hurobomaster/TriCoSphere/STL/TriCoSphere - 单指节-3 挡边轴承3-6-2.5-25.STL

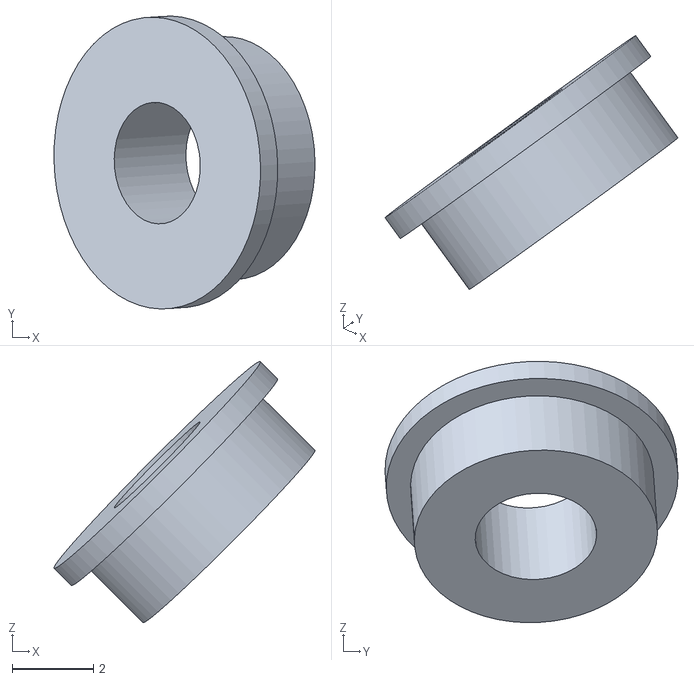
[picture p2: CAD file, 2026-02-28]
STL/TriCoSphere - 单指节-3 挡边轴承3-6-2.5-25.STL
6.43 x 7.22 x 6.44
