hurobomaster/TriCoSphere/STL/TriCoSphere - 单指节-2 M2.5锁紧螺母-1.STL

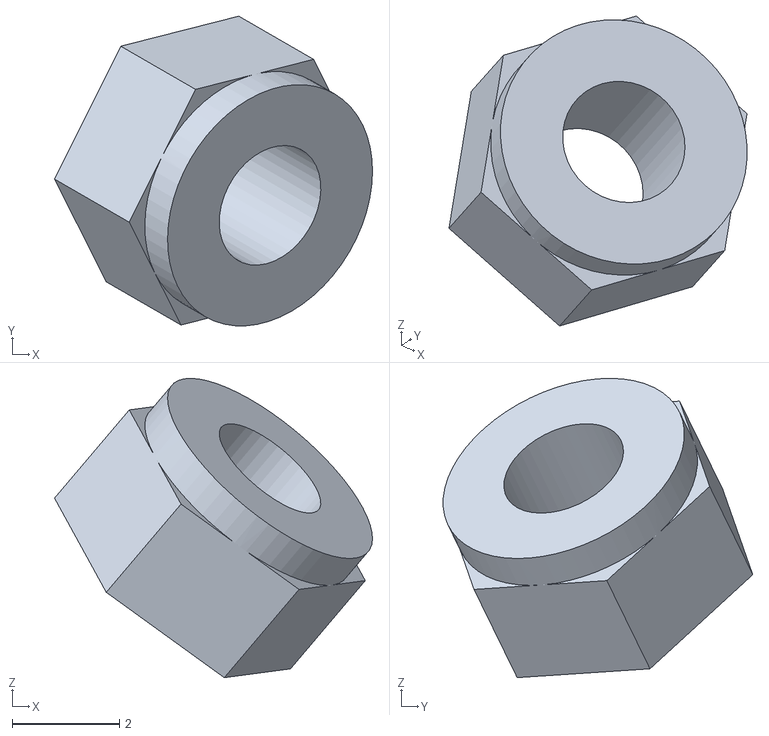
[picture p3: CAD file, 2026-02-28]
STL/TriCoSphere - 单指节-2 M2.5锁紧螺母-1.STL
5.93 x 5.77 x 5.58
