hurobomaster/TriCoSphere/STL/TriCoSphere - 单指节-3 3-1支架-1.STL

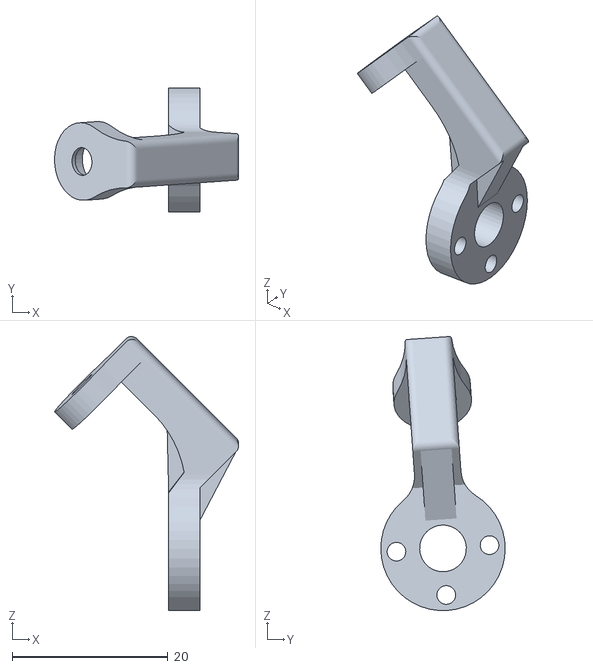
[picture p4: CAD file, 2026-02-28]
STL/TriCoSphere - 单指节-3 3-1支架-1.STL
23.7 x 16.0 x 35.2
