hurobomaster/TriCoSphere/STL/TriCoSphere - 单指节-3 4-1支架-2.STL

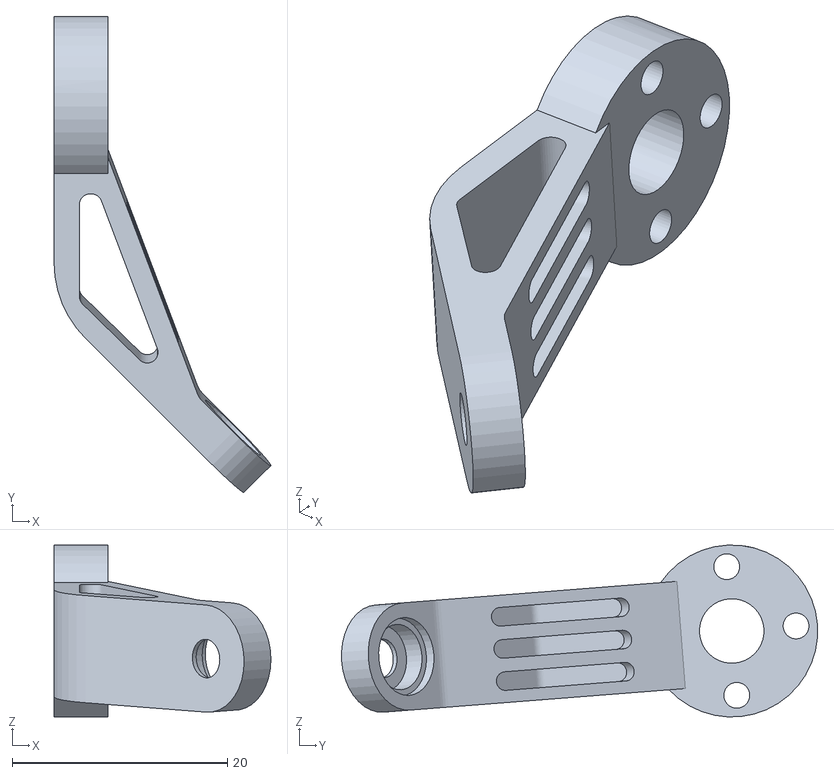
[picture p5: CAD file, 2026-02-28]
STL/TriCoSphere - 单指节-3 4-1支架-2.STL
20.2 x 44.3 x 16.0
