hurobomaster/TriCoSphere/STL/TriCoSphere - 单指节-2 挡边轴承3-6-2.5-26.STL

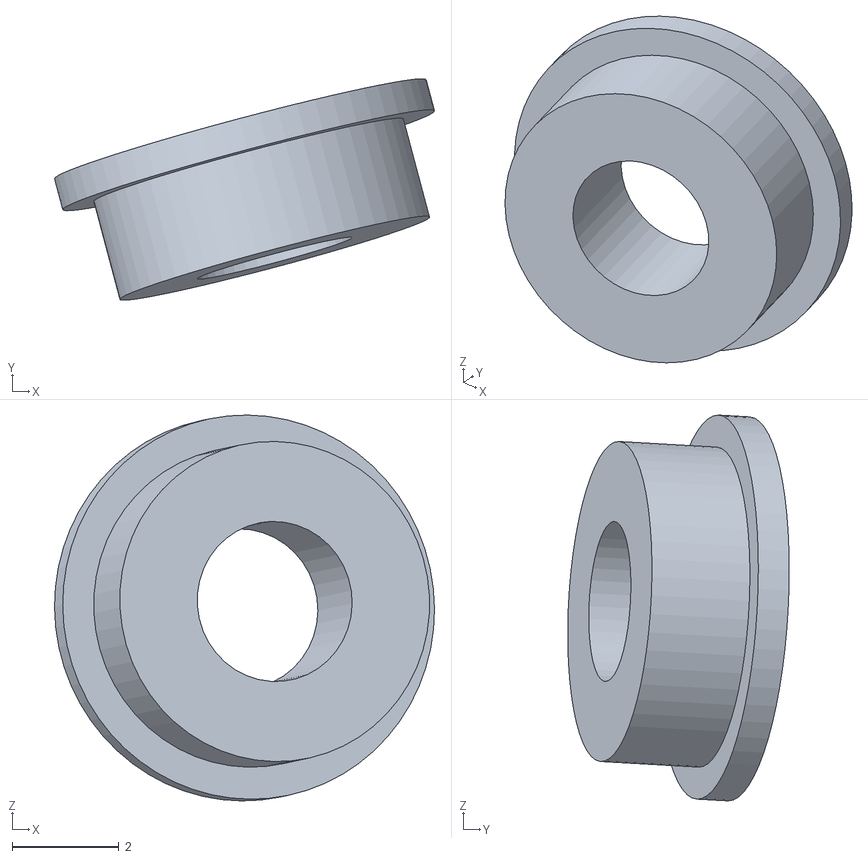
[picture p6: CAD file, 2026-02-28]
STL/TriCoSphere - 单指节-2 挡边轴承3-6-2.5-26.STL
7.11 x 4.15 x 7.22
