hurobomaster/TriCoSphere/STL/TriCoSphere - 单指节-2 长腿2-1.STL

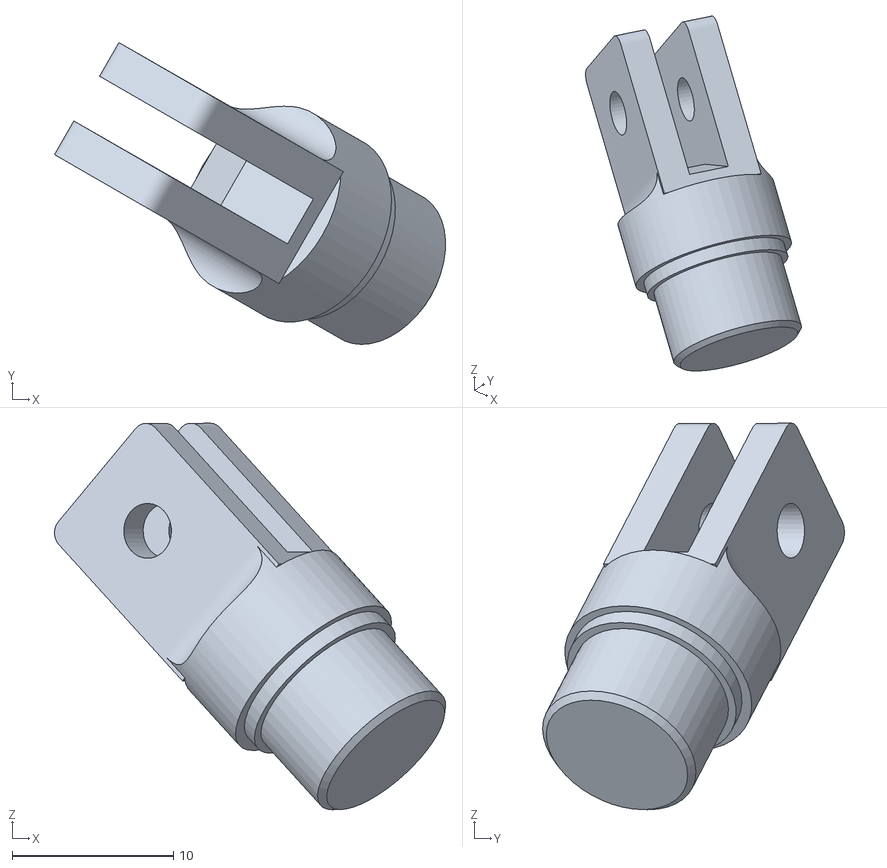
[picture p7: CAD file, 2026-02-28]
STL/TriCoSphere - 单指节-2 长腿2-1.STL
24.2 x 18.7 x 23.9
