hurobomaster/TriCoSphere/STL/TriCoSphere - 单指节-1 中指模块-1.STL

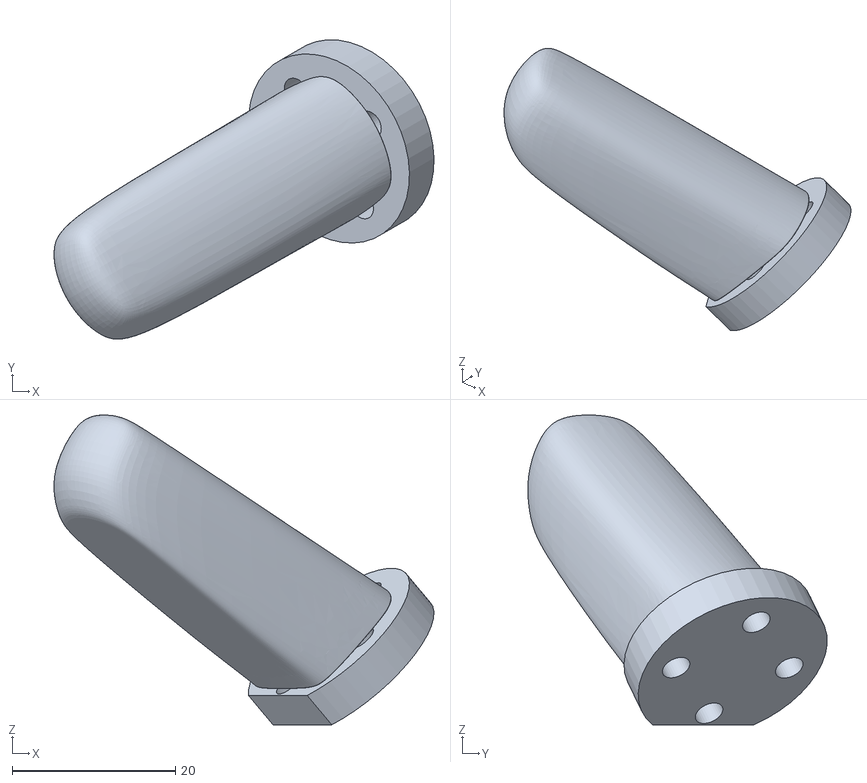
[picture p8: CAD file, 2026-02-28]
STL/TriCoSphere - 单指节-1 中指模块-1.STL
46.5 x 36.6 x 37.9
