hurobomaster/TriCoSphere/STL/TriCoSphere - 单指节-2 推力球轴承3_8_3.5-5.STL

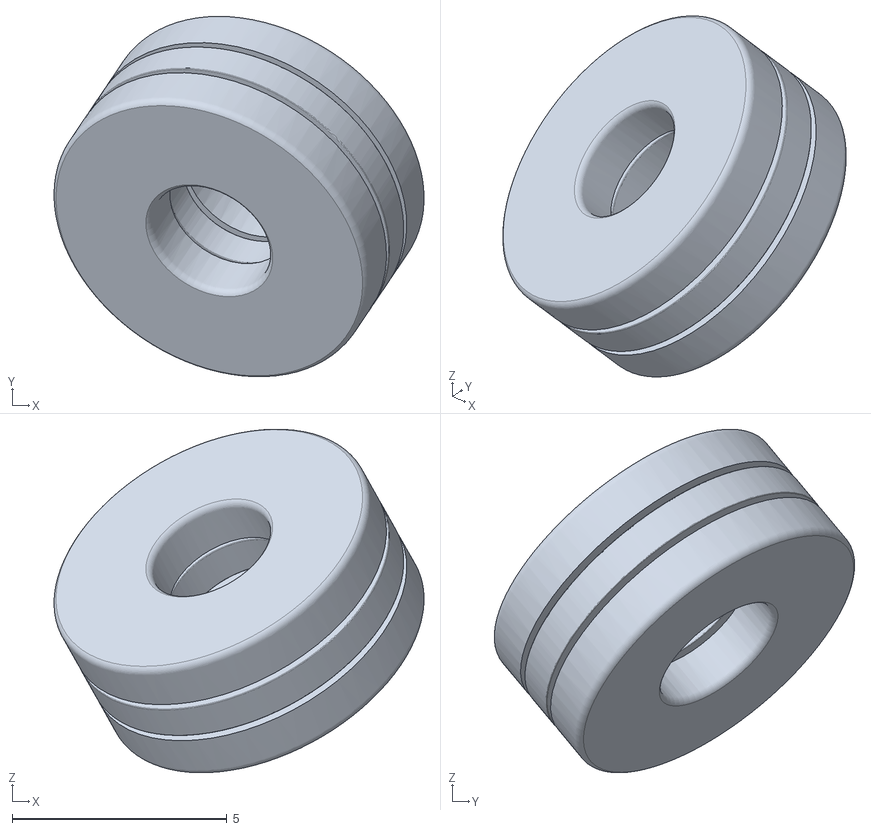
[picture p9: CAD file, 2026-02-28]
STL/TriCoSphere - 单指节-2 推力球轴承3_8_3.5-5.STL
8.62 x 8.39 x 8.00
