hurobomaster/TriCoSphere/STL/TriCoSphere - 单指节-1 M2.5塞打-2.STL

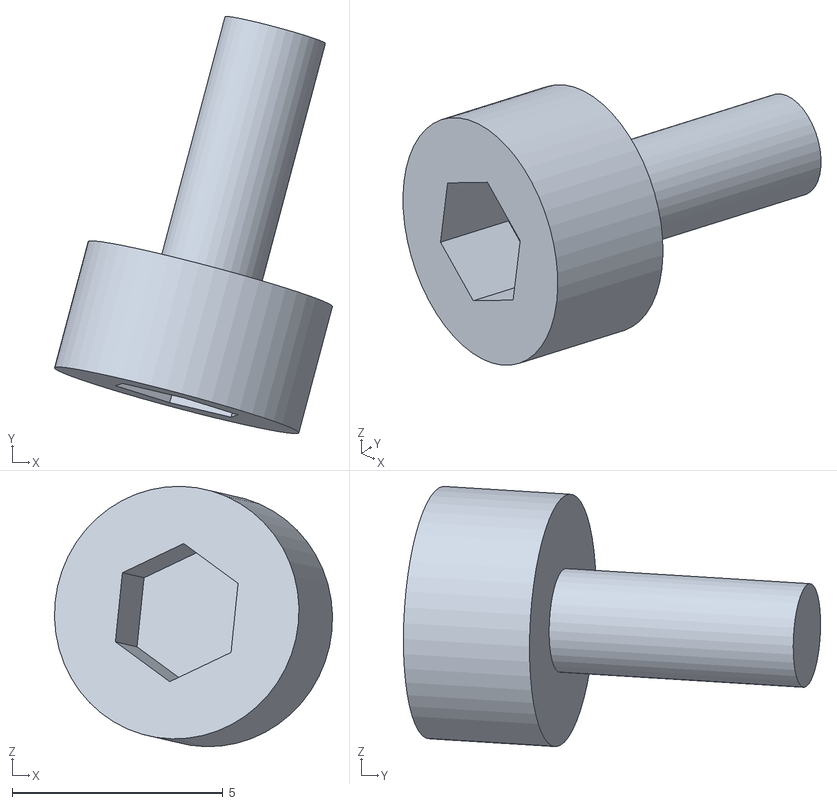
[picture p10: CAD file, 2026-02-28]
STL/TriCoSphere - 单指节-1 M2.5塞打-2.STL
6.59 x 9.89 x 6.17
