hurobomaster/TriCoSphere/STL/TriCoSphere - 单指节-3 1-2支架-1.STL

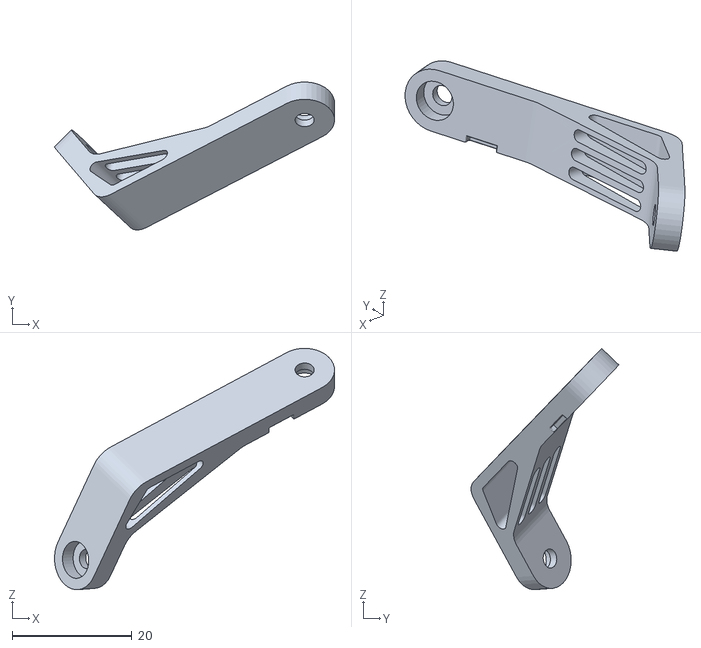
[picture p11: CAD file, 2026-02-28]
STL/TriCoSphere - 单指节-3 1-2支架-1.STL
46.8 x 24.7 x 40.3
