hurobomaster/TriCoSphere/STL/TriCoSphere - 单指节-3 长边件-9.STL

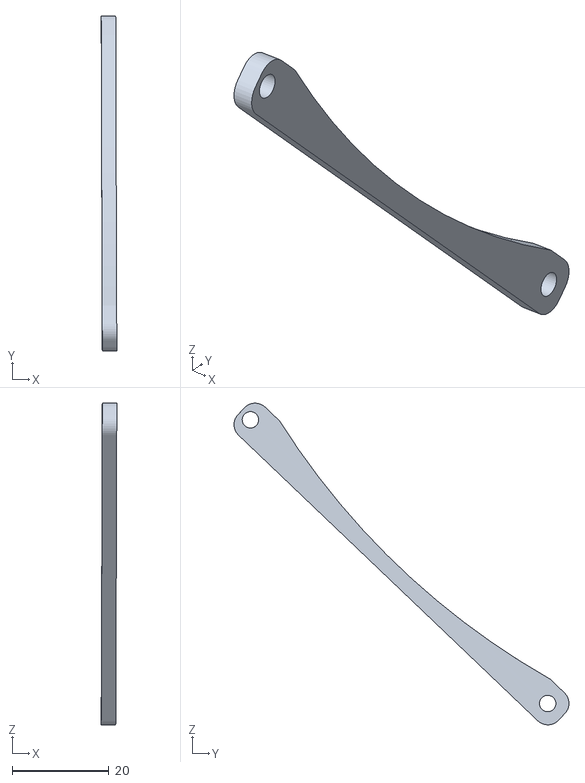
[picture p12: CAD file, 2026-02-28]
STL/TriCoSphere - 单指节-3 长边件-9.STL
3.22 x 69.3 x 66.5
