hurobomaster/TriCoSphere/STL/TriCoSphere - 单指节-3 aututorM288-2.STL

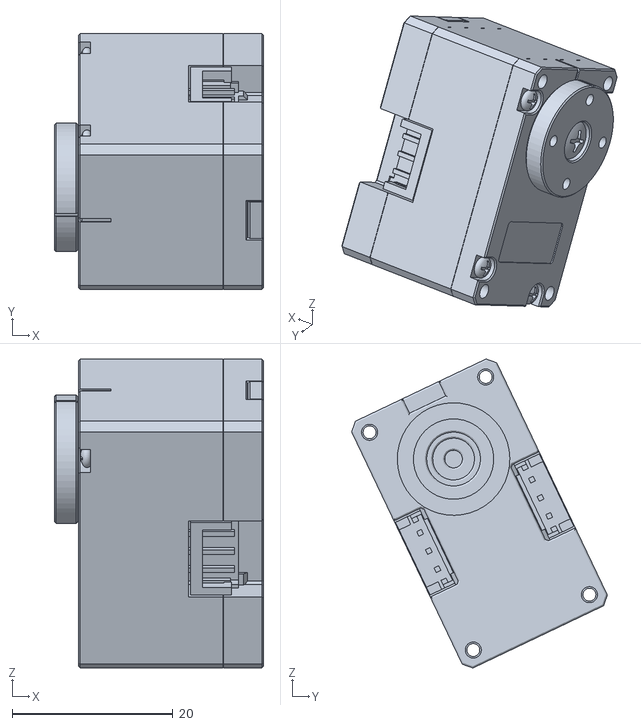
[picture p13: CAD file, 2026-02-28]
STL/TriCoSphere - 单指节-3 aututorM288-2.STL
26.0 x 31.8 x 38.4
