hurobomaster/TriCoSphere/STL/TriCoSphere - 单指节-2 内六角杯头螺栓 SCA SCAS[SCA-M3-L8]-2.STL

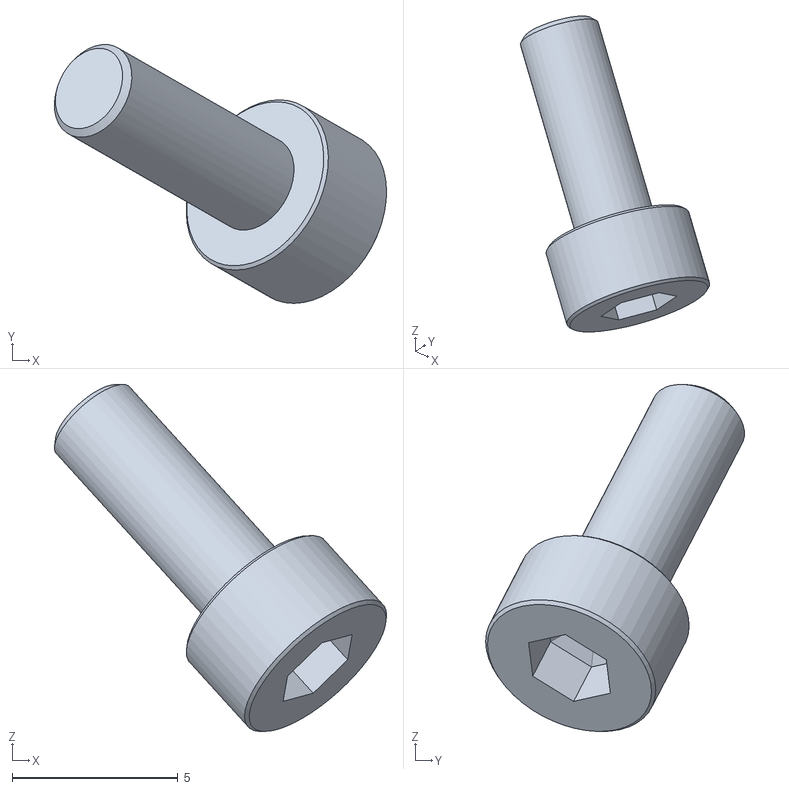
[picture p14: CAD file, 2026-02-28]
STL/TriCoSphere - 单指节-2 内六角杯头螺栓 SCA SCAS[SCA-M3-L8]-2.STL
10.0 x 7.80 x 10.5
