hurobomaster/TriCoSphere/STL/TriCoSphere - 单指节-1 aututorM288-1.STL

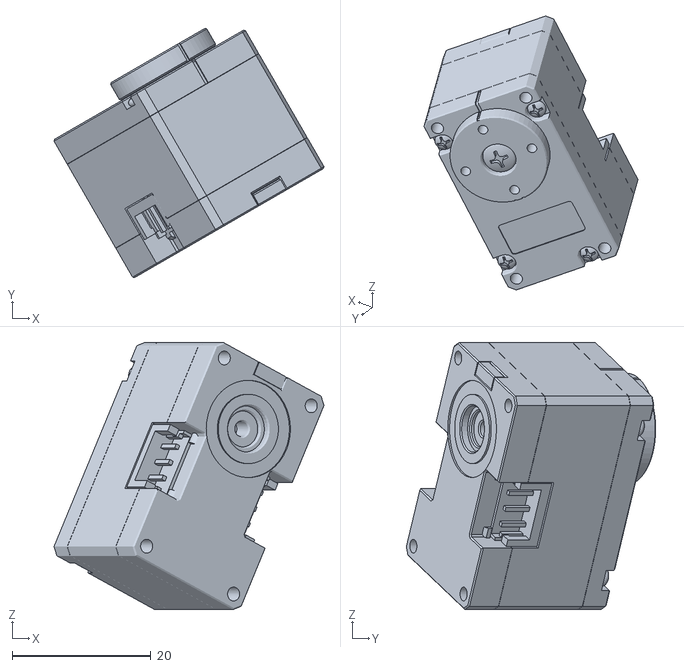
[picture p15: CAD file, 2026-02-28]
STL/TriCoSphere - 单指节-1 aututorM288-1.STL
38.9 x 35.9 x 38.4
