hurobomaster/TriCoSphere/STL/TriCoSphere - 单指节-2 1-2支架-1.STL

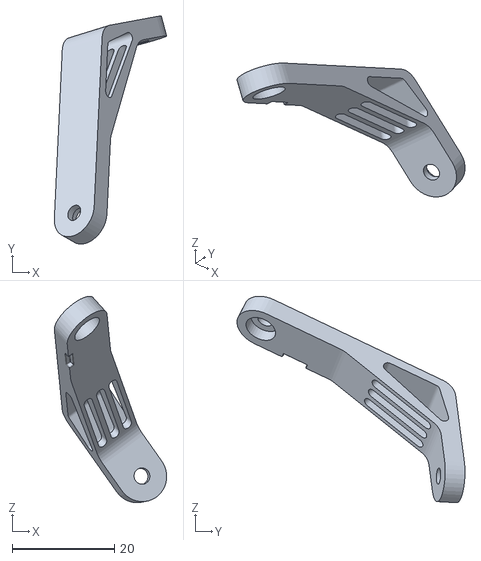
[picture p16: CAD file, 2026-02-28]
STL/TriCoSphere - 单指节-2 1-2支架-1.STL
21.9 x 44.5 x 40.3
