hurobomaster/TriCoSphere/STL/TriCoSphere - 单指节-3 内六角杯头螺栓 SCA SCAS[SCA-M3-L8]-4.STL

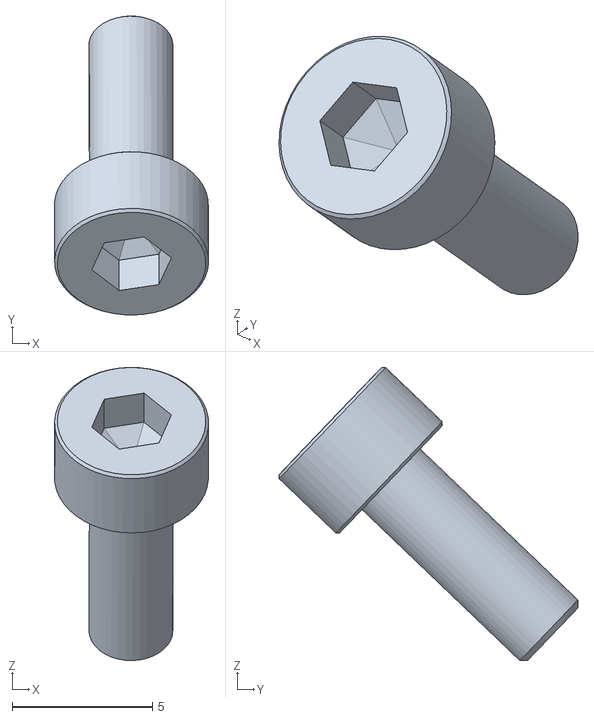
[picture p17: CAD file, 2026-02-28]
STL/TriCoSphere - 单指节-3 内六角杯头螺栓 SCA SCAS[SCA-M3-L8]-4.STL
5.50 x 10.7 x 10.5
