hurobomaster/TriCoSphere/STL/TriCoSphere - 单指节-3 2-2支架-4.STL

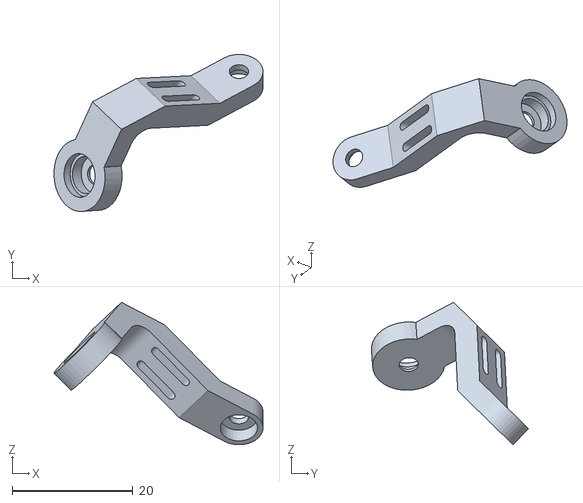
[picture p18: CAD file, 2026-02-28]
STL/TriCoSphere - 单指节-3 2-2支架-4.STL
34.7 x 26.1 x 23.6
