hurobomaster/TriCoSphere/STL/TriCoSphere - 单指节-2 挡边轴承3-6-2.5-16.STL

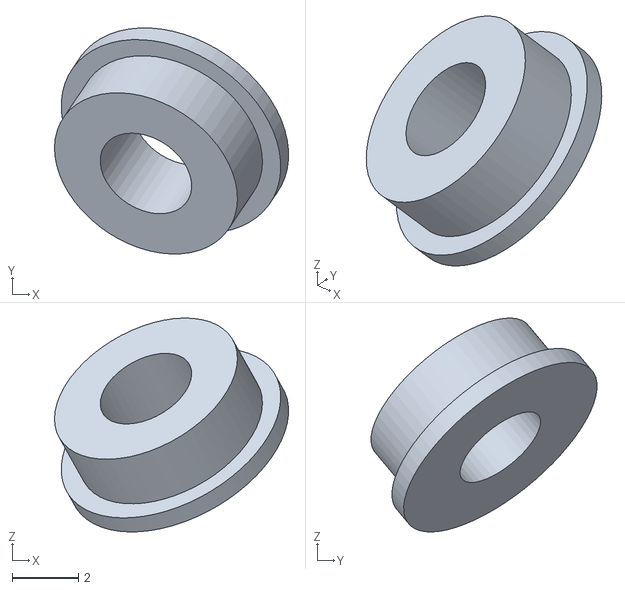
[picture p19: CAD file, 2026-02-28]
STL/TriCoSphere - 单指节-2 挡边轴承3-6-2.5-16.STL
7.05 x 6.80 x 6.44
