hurobomaster/TriCoSphere/STL/TriCoSphere - 单指节-2 挡边轴承3-6-2.5-25.STL

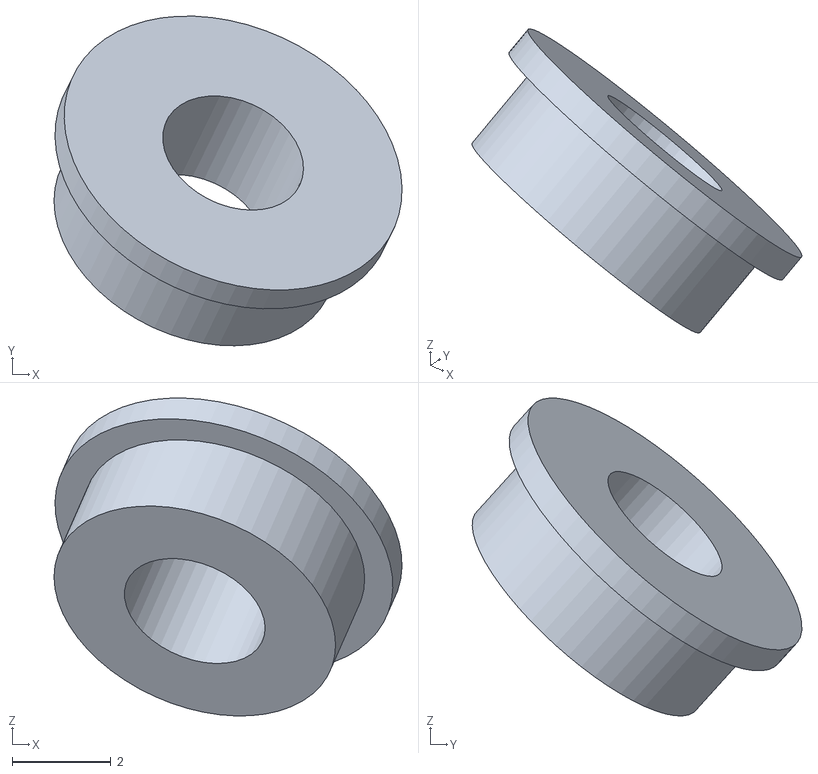
[picture p20: CAD file, 2026-02-28]
STL/TriCoSphere - 单指节-2 挡边轴承3-6-2.5-25.STL
7.05 x 6.68 x 6.44
