hurobomaster/TriCoSphere/STL/TriCoSphere - 单指节-3 短边连接-1.STL

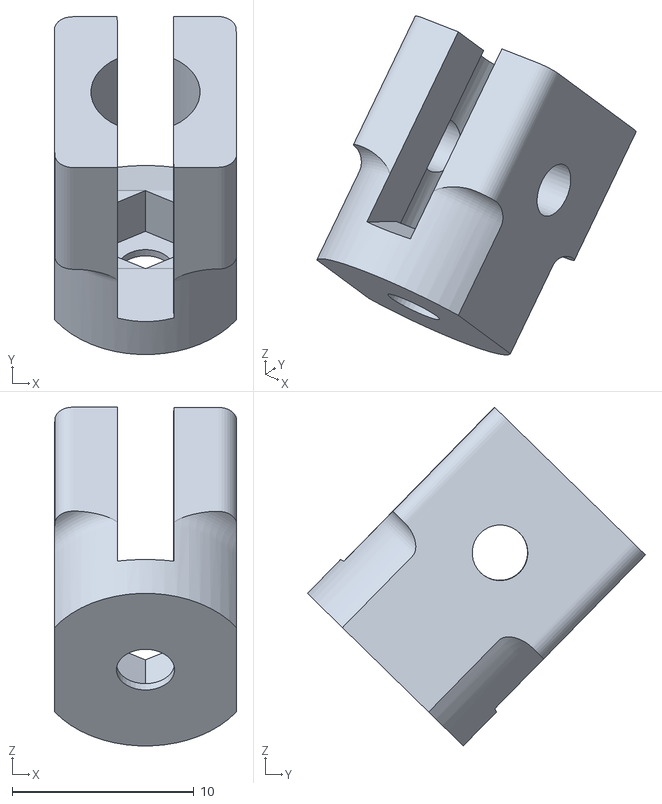
[picture p21: CAD file, 2026-02-28]
STL/TriCoSphere - 单指节-3 短边连接-1.STL
10.0 x 18.6 x 18.6
