hurobomaster/TriCoSphere/STL/TriCoSphere - 单指节-1 推力球轴承3_8_3.5-6.STL

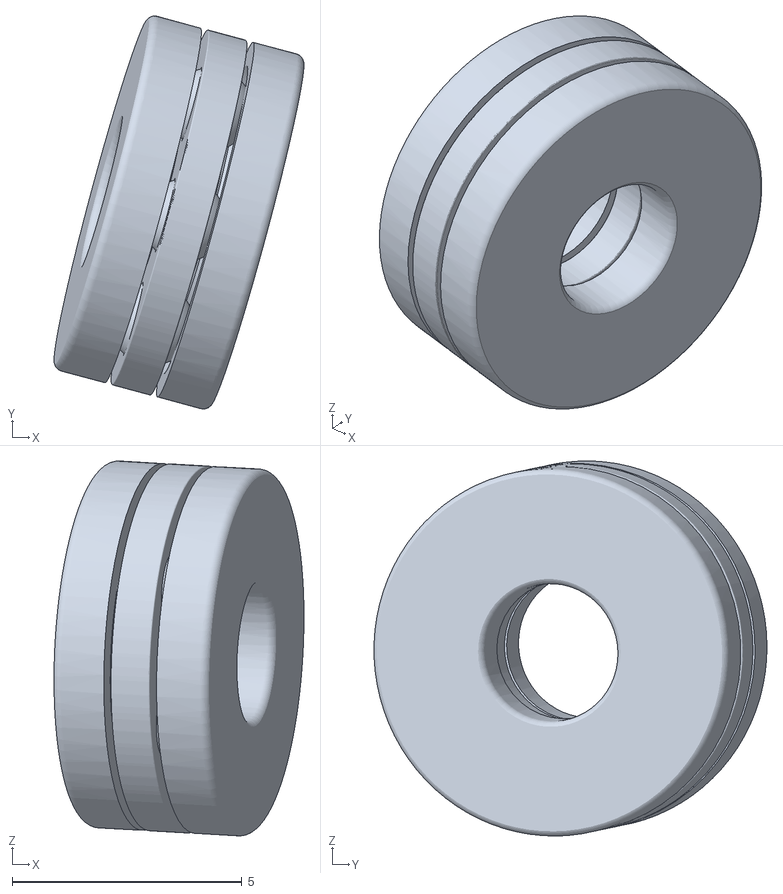
[picture p22: CAD file, 2026-02-28]
STL/TriCoSphere - 单指节-1 推力球轴承3_8_3.5-6.STL
5.44 x 8.55 x 8.16
