hurobomaster/TriCoSphere/STL/TriCoSphere - 单指节-1 4-1支架-1.STL

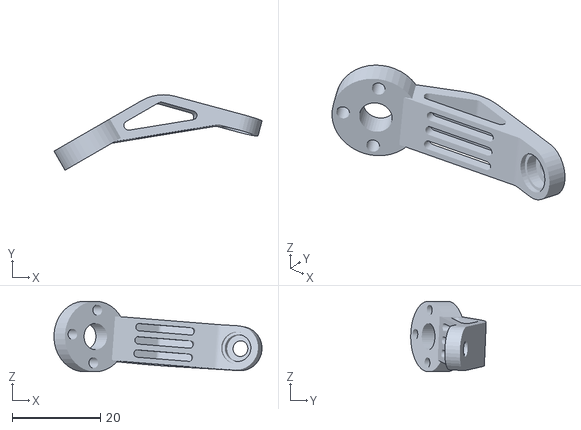
[picture p23: CAD file, 2026-02-28]
STL/TriCoSphere - 单指节-1 4-1支架-1.STL
47.2 x 17.1 x 16.0
