hurobomaster/TriCoSphere/STL/TriCoSphere - 单指节-3 推力球轴承3_8_3.5-9.STL

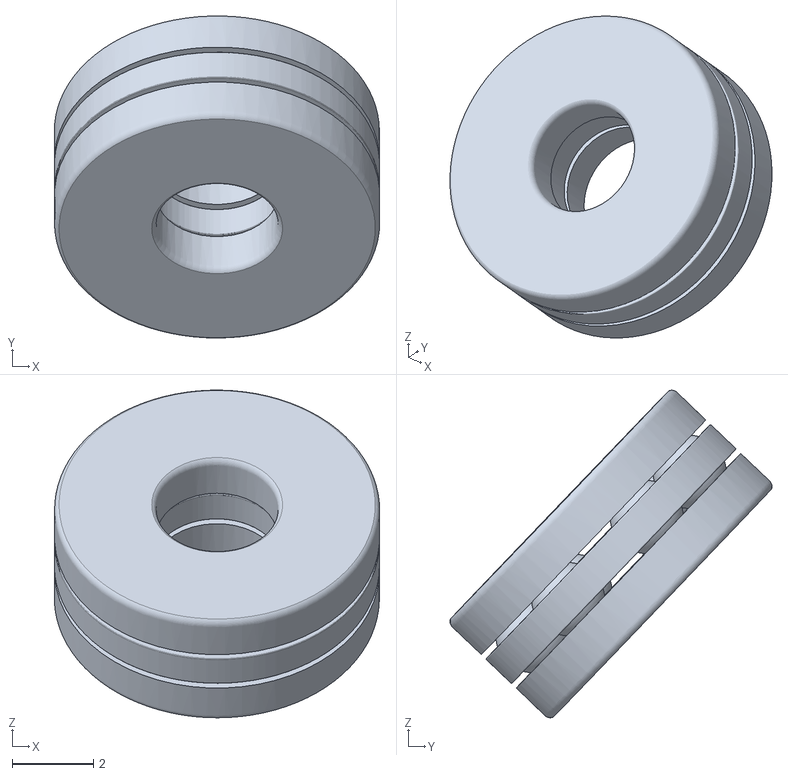
[picture p24: CAD file, 2026-02-28]
STL/TriCoSphere - 单指节-3 推力球轴承3_8_3.5-9.STL
8.01 x 7.92 x 8.06
