hurobomaster/TriCoSphere/STL/TriCoSphere - 单指节-3 推力球轴承3_8_3.5-7.STL

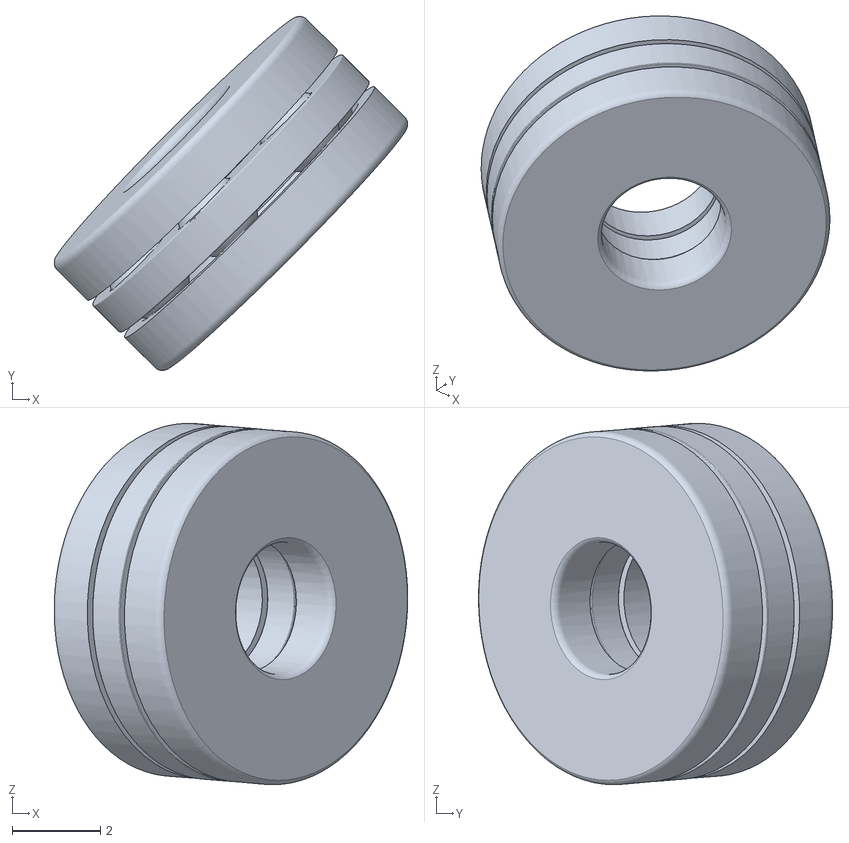
[picture p25: CAD file, 2026-02-28]
STL/TriCoSphere - 单指节-3 推力球轴承3_8_3.5-7.STL
7.99 x 8.01 x 8.17
