hurobomaster/TriCoSphere/STL/TriCoSphere - 单指节-1 M3螺母-4.STL

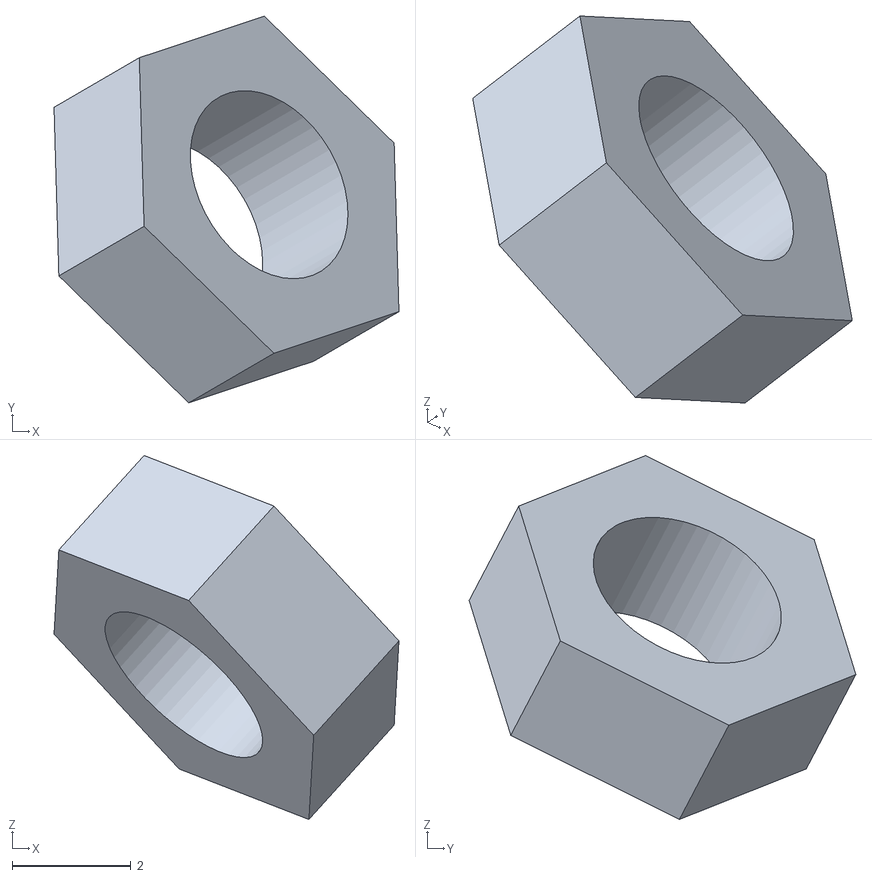
[picture p26: CAD file, 2026-02-28]
STL/TriCoSphere - 单指节-1 M3螺母-4.STL
5.81 x 6.51 x 6.13
