hurobomaster/TriCoSphere/STL/TriCoSphere - 单指节-2 超薄轴承-3.STL

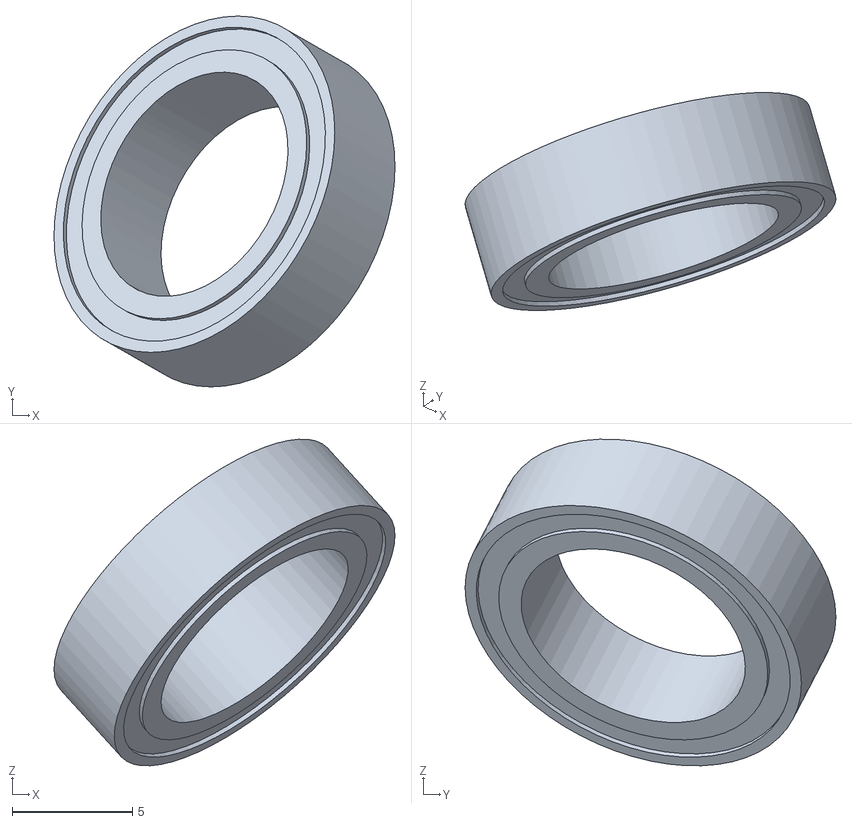
[picture p27: CAD file, 2026-02-28]
STL/TriCoSphere - 单指节-2 超薄轴承-3.STL
14.2 x 15.4 x 13.6
