hurobomaster/TriCoSphere/STL/TriCoSphere - 单指节-3 长腿盖-1.STL

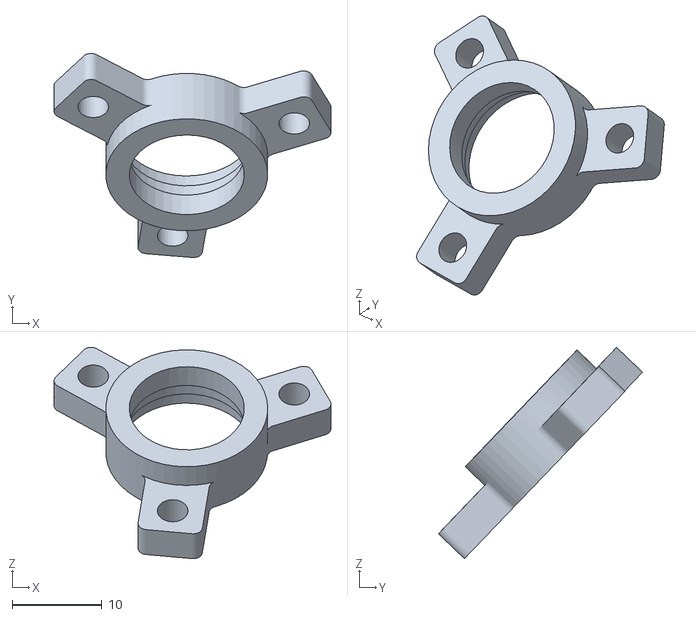
[picture p28: CAD file, 2026-02-28]
STL/TriCoSphere - 单指节-3 长腿盖-1.STL
30.8 x 22.7 x 23.5
