hurobomaster/TriCoSphere/STL/TriCoSphere - 单指节-1 推力球轴承3_8_3.5-7.STL

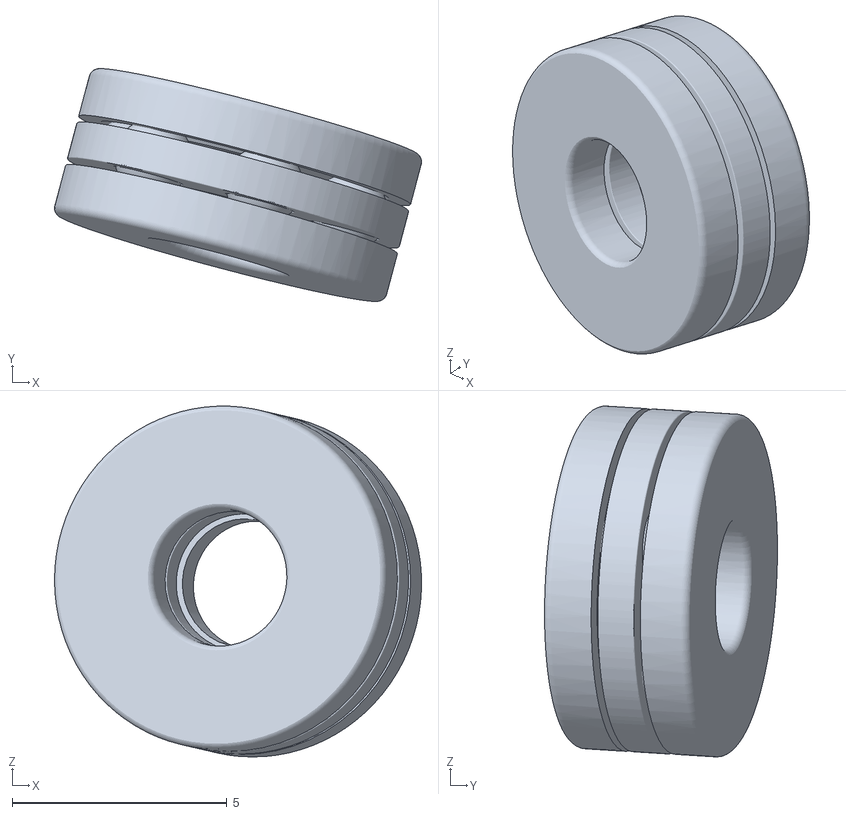
[picture p29: CAD file, 2026-02-28]
STL/TriCoSphere - 单指节-1 推力球轴承3_8_3.5-7.STL
8.55 x 5.43 x 8.17
