hurobomaster/TriCoSphere/STL/TriCoSphere - 单指节-1 2-1支架-1.STL

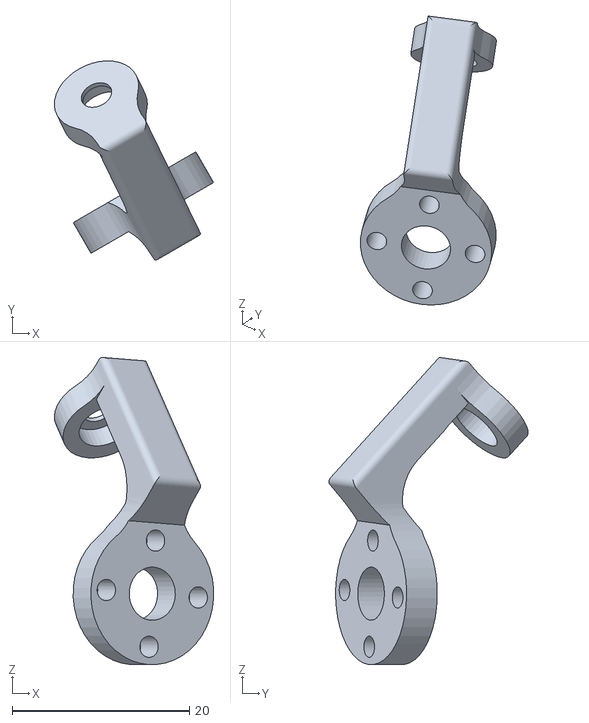
[picture p30: CAD file, 2026-02-28]
STL/TriCoSphere - 单指节-1 2-1支架-1.STL
18.0 x 22.5 x 34.6
