hurobomaster/TriCoSphere/STL/TriCoSphere - 单指节-1 挡边轴承3-6-2.5-26.STL

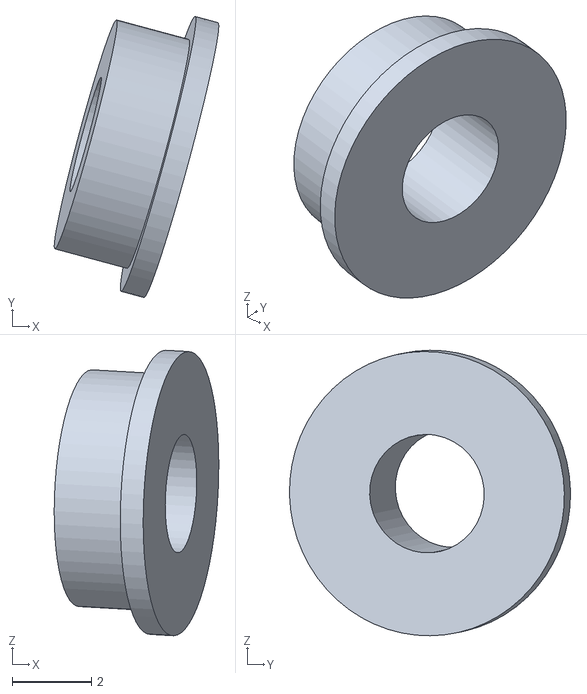
[picture p31: CAD file, 2026-02-28]
STL/TriCoSphere - 单指节-1 挡边轴承3-6-2.5-26.STL
4.16 x 7.11 x 7.22
