hurobomaster/TriCoSphere/STL/TriCoSphere - 单指节-1 4-1支架-2.STL

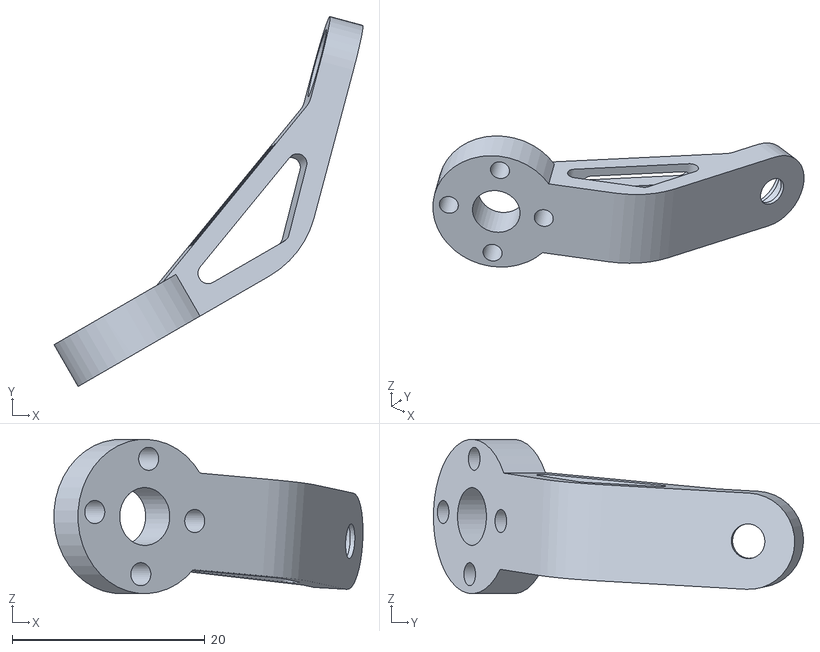
[picture p32: CAD file, 2026-02-28]
STL/TriCoSphere - 单指节-1 4-1支架-2.STL
32.0 x 38.4 x 16.0
