hurobomaster/TriCoSphere/STL/TriCoSphere - 单指节-2 2-1支架-1.STL

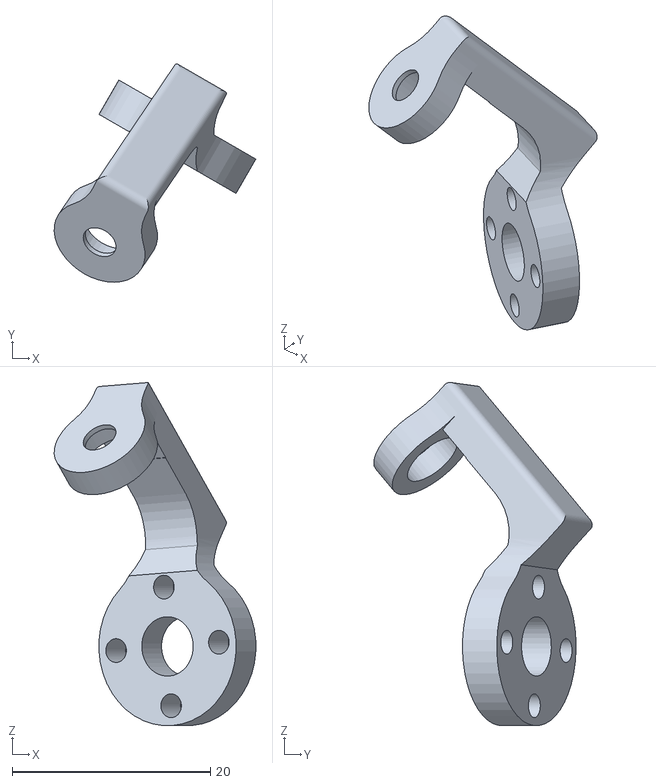
[picture p33: CAD file, 2026-02-28]
STL/TriCoSphere - 单指节-2 2-1支架-1.STL
20.4 x 22.1 x 34.6
