hurobomaster/TriCoSphere/STL/TriCoSphere - 单指节-2 2-2支架-4.STL

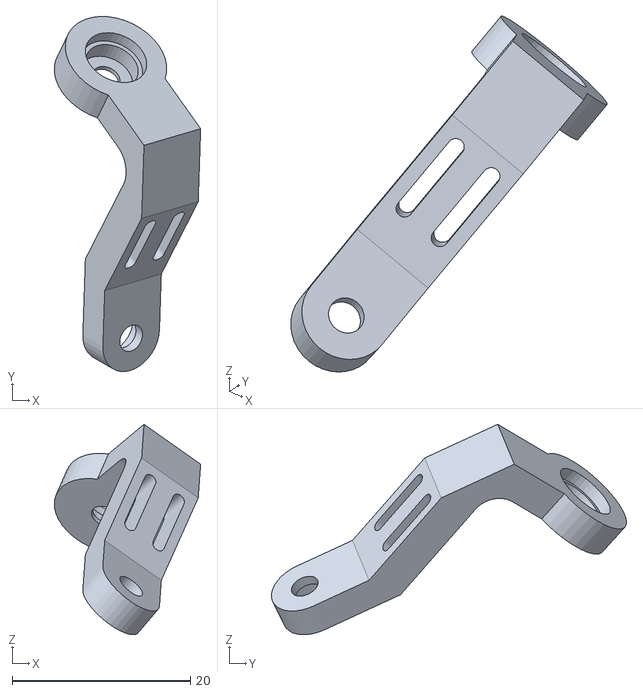
[picture p34: CAD file, 2026-02-28]
STL/TriCoSphere - 单指节-2 2-2支架-4.STL
16.4 x 39.9 x 23.6
