hurobomaster/TriCoSphere/STL/TriCoSphere - 单指节-2 M3螺母-4.STL

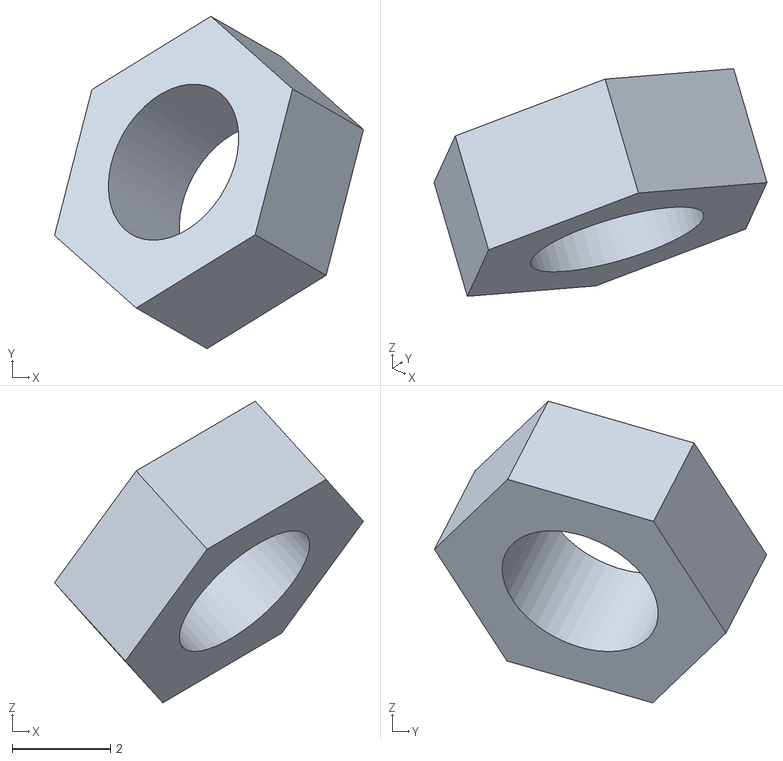
[picture p35: CAD file, 2026-02-28]
STL/TriCoSphere - 单指节-2 M3螺母-4.STL
6.28 x 6.75 x 6.13
