hurobomaster/TriCoSphere/STL/TriCoSphere - 单指节-1 M3螺母-1.STL

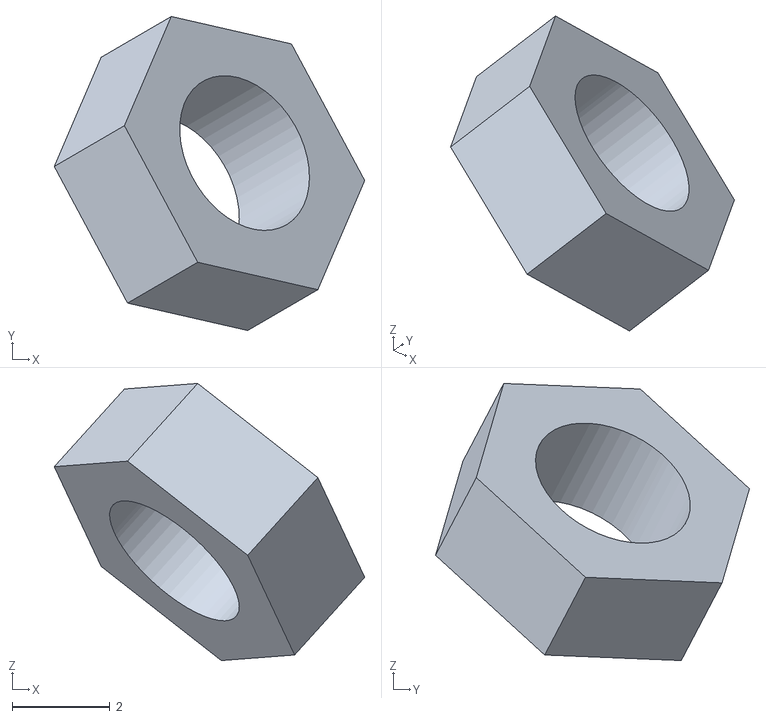
[picture p36: CAD file, 2026-02-28]
STL/TriCoSphere - 单指节-1 M3螺母-1.STL
6.36 x 6.43 x 5.67
