hurobomaster/TriCoSphere/STL/TriCoSphere - 单指节-2 挡边轴承3-6-2.5-21.STL

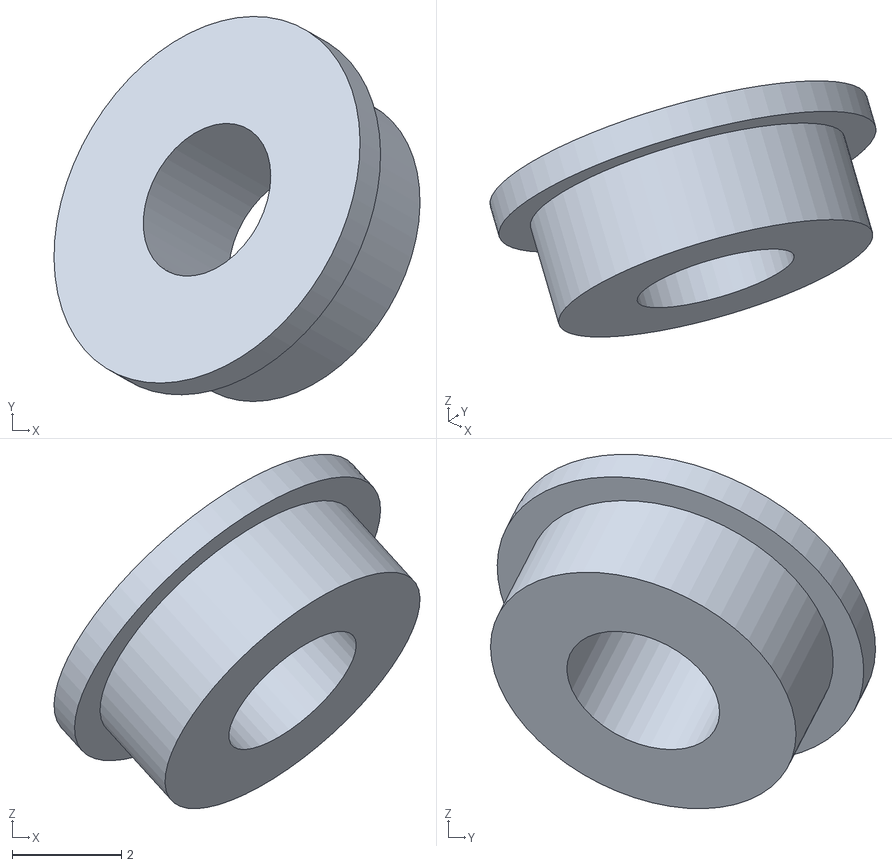
[picture p37: CAD file, 2026-02-28]
STL/TriCoSphere - 单指节-2 挡边轴承3-6-2.5-21.STL
6.71 x 7.06 x 6.49
