hurobomaster/TriCoSphere/STL/TriCoSphere - 单指节-3 长腿2-1.STL

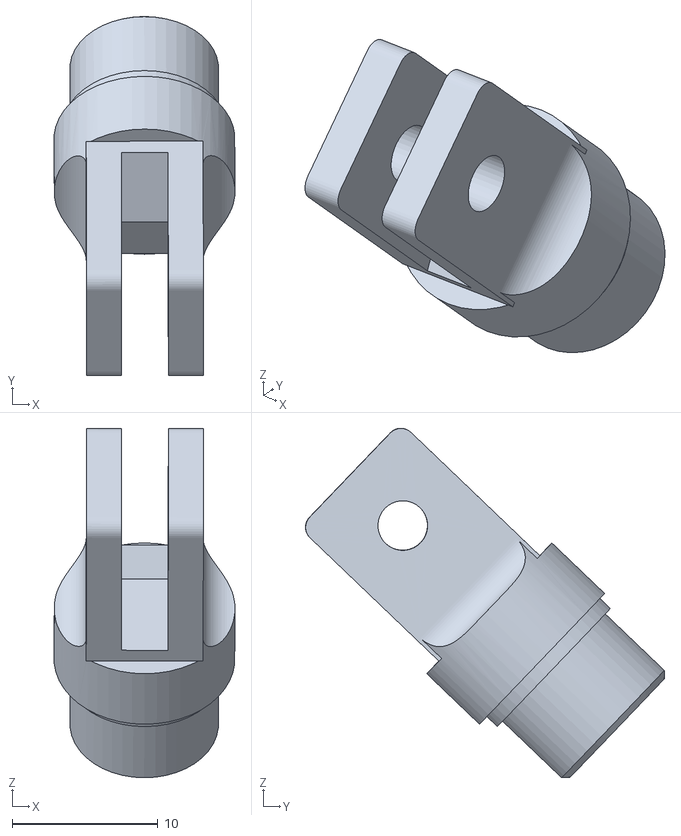
[picture p38: CAD file, 2026-02-28]
STL/TriCoSphere - 单指节-3 长腿2-1.STL
12.4 x 24.6 x 23.9
