hurobomaster/TriCoSphere/STL/TriCoSphere - 单指节-3 M2.5塞打-4.STL

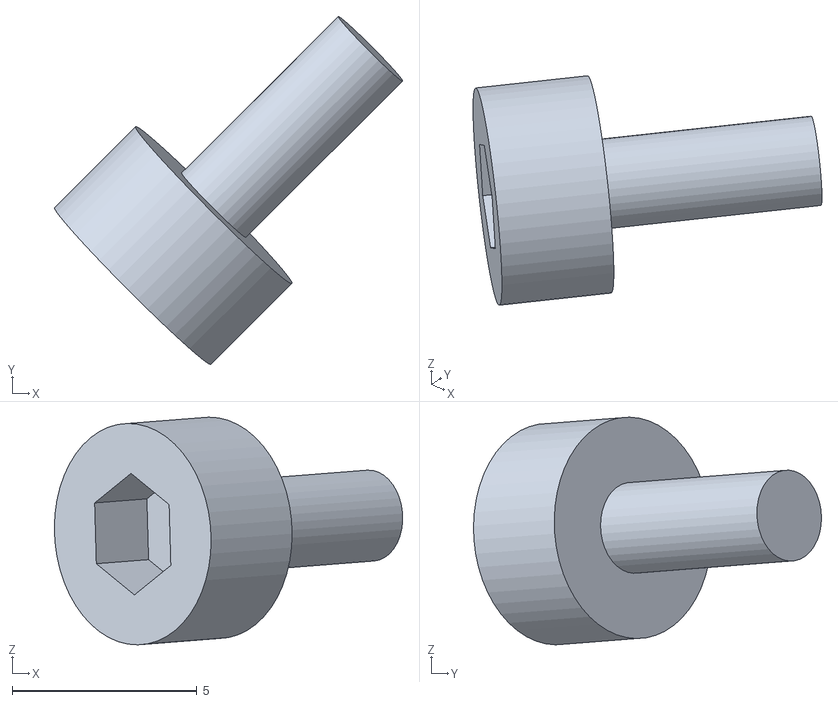
[picture p39: CAD file, 2026-02-28]
STL/TriCoSphere - 单指节-3 M2.5塞打-4.STL
9.43 x 9.42 x 6.16
