hurobomaster/TriCoSphere/STL/TriCoSphere - 单指节-3 挡边轴承3-6-2.5-9.STL

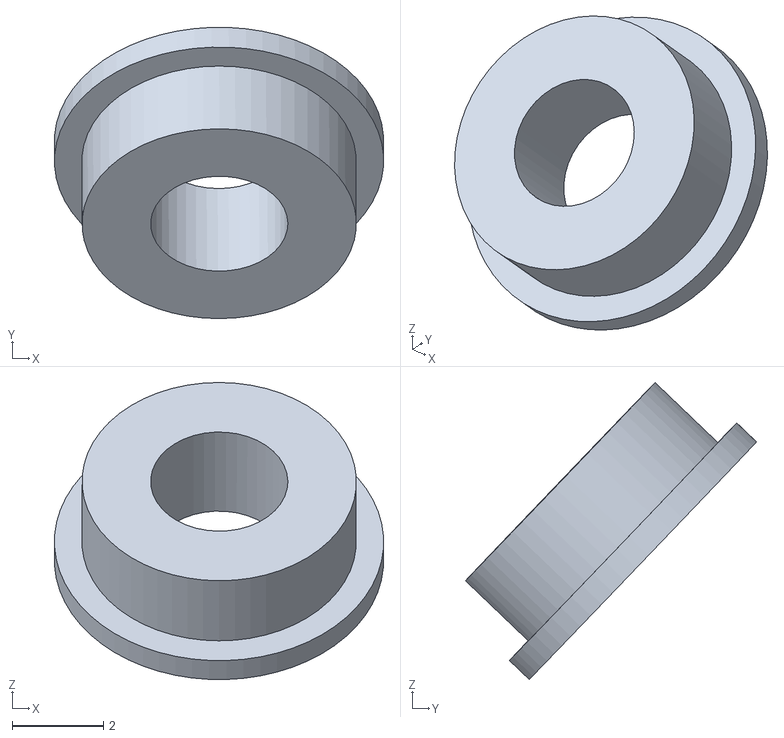
[picture p40: CAD file, 2026-02-28]
STL/TriCoSphere - 单指节-3 挡边轴承3-6-2.5-9.STL
7.19 x 6.37 x 6.49
