hurobomaster/TriCoSphere/STL/TriCoSphere - 单指节-1 M2.5塞打-5.STL

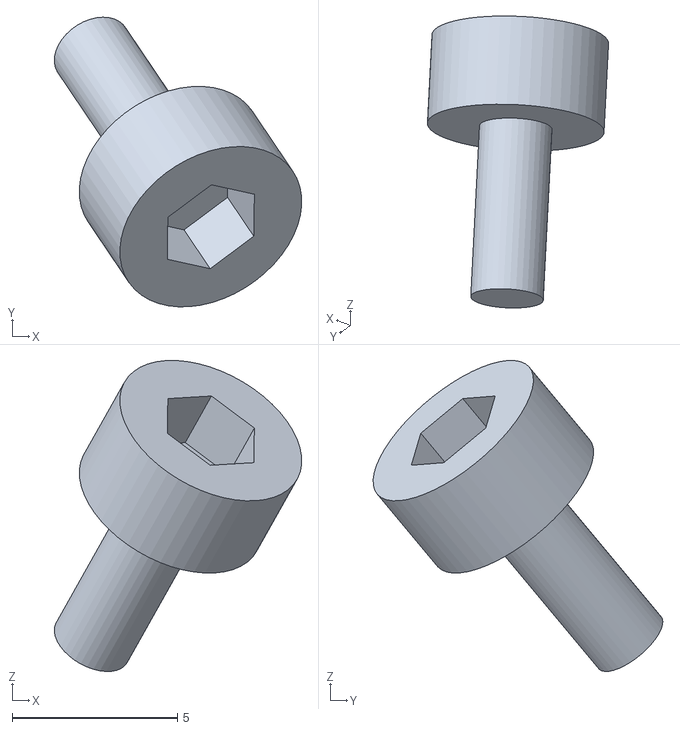
[picture p41: CAD file, 2026-02-28]
STL/TriCoSphere - 单指节-1 M2.5塞打-5.STL
7.49 x 8.77 x 9.42
