hurobomaster/TriCoSphere/STL/TriCoSphere - 单指节-1 长腿1-2.STL

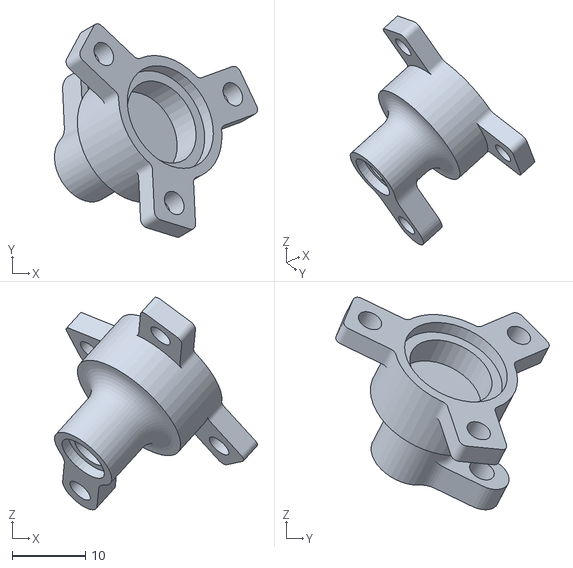
[picture p42: CAD file, 2026-02-28]
STL/TriCoSphere - 单指节-1 长腿1-2.STL
27.6 x 29.1 x 28.9
