hurobomaster/TriCoSphere/STL/TriCoSphere - 单指节-2 M3螺母-2.STL

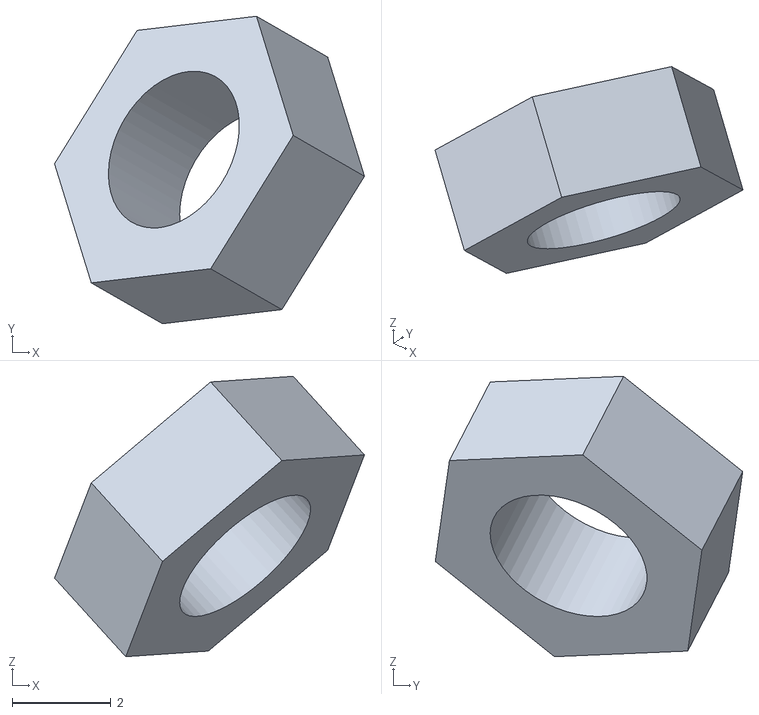
[picture p43: CAD file, 2026-02-28]
STL/TriCoSphere - 单指节-2 M3螺母-2.STL
6.27 x 6.22 x 5.67
