hurobomaster/TriCoSphere/STL/TriCoSphere - 单指节-2 推力球轴承3_8_3.5-9.STL

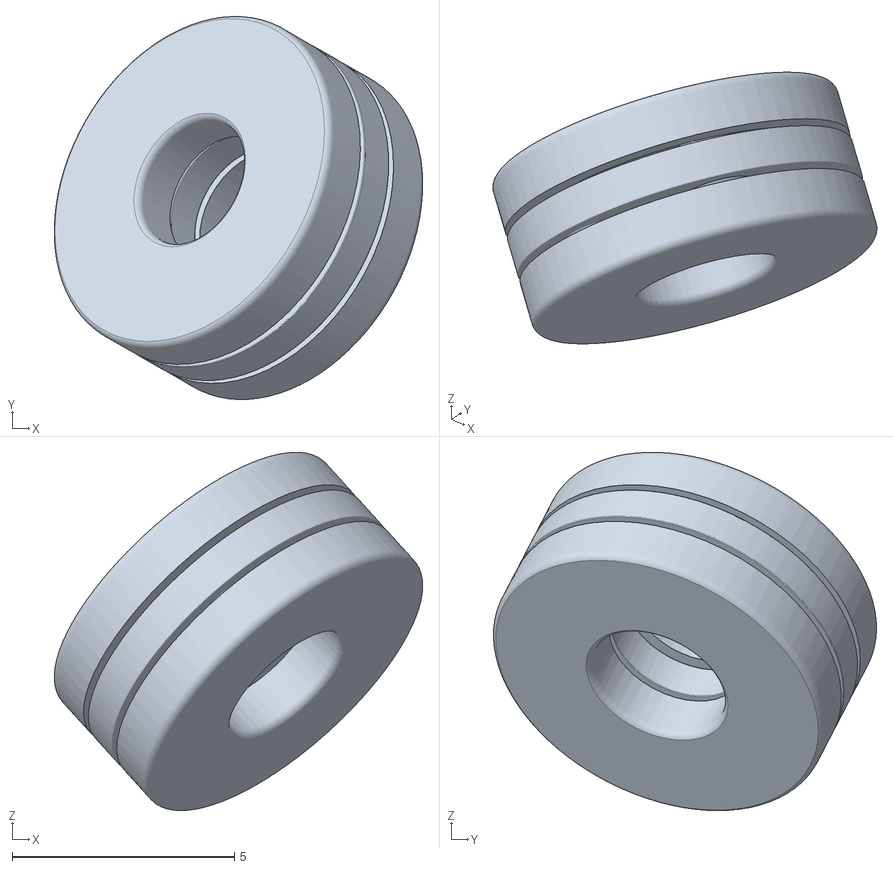
[picture p44: CAD file, 2026-02-28]
STL/TriCoSphere - 单指节-2 推力球轴承3_8_3.5-9.STL
8.29 x 8.62 x 8.06
