hurobomaster/TriCoSphere/STL/TriCoSphere - 单指节-2 球体-2.STL

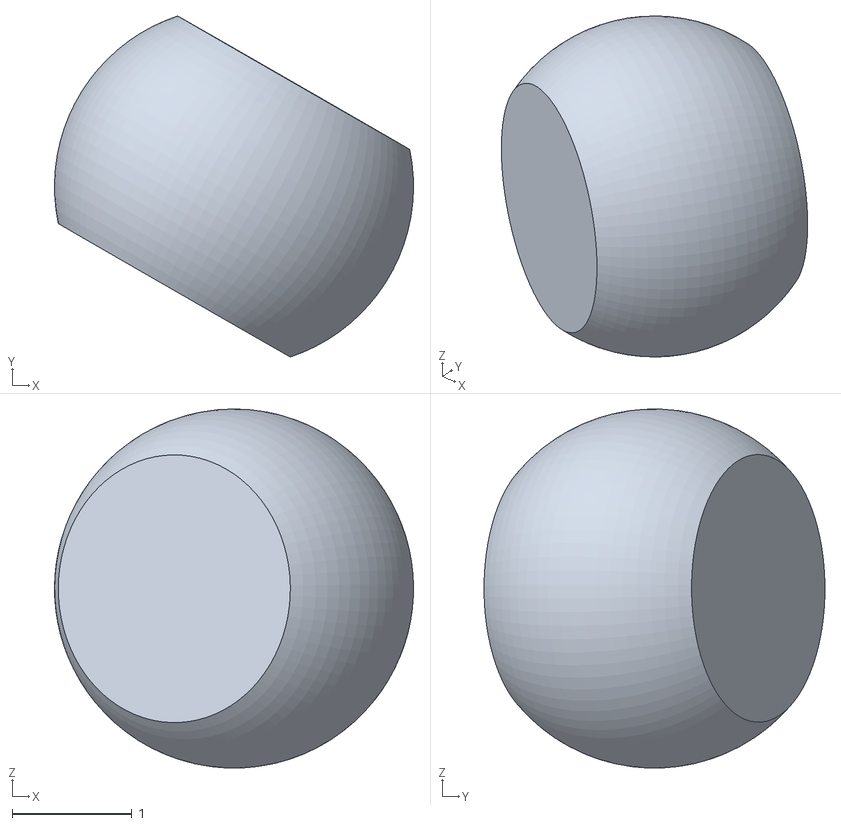
[picture p45: CAD file, 2026-02-28]
STL/TriCoSphere - 单指节-2 球体-2.STL
3.00 x 2.85 x 3.00
