hurobomaster/TriCoSphere/STL/TriCoSphere - 单指节-2 M3螺母-5.STL

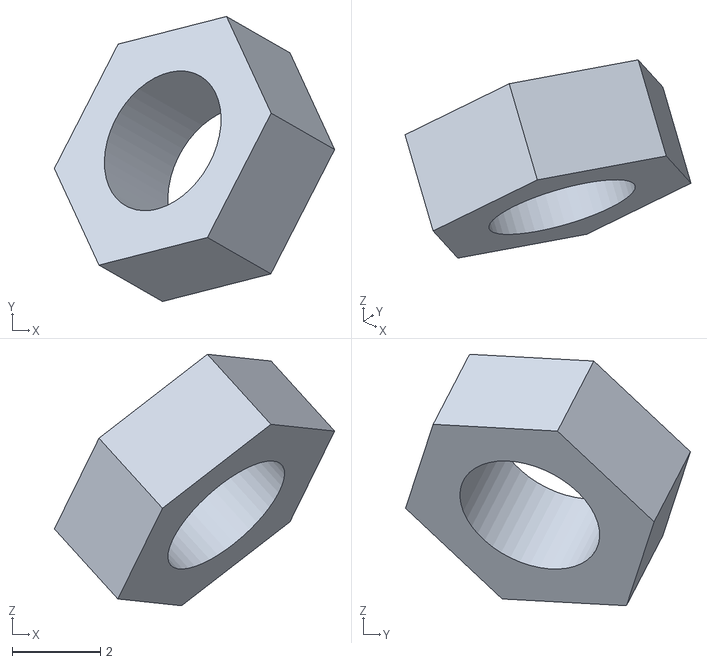
[picture p46: CAD file, 2026-02-28]
STL/TriCoSphere - 单指节-2 M3螺母-5.STL
6.36 x 6.47 x 5.71
