hurobomaster/TriCoSphere/STL/TriCoSphere - 单指节-2 3-2支架-2.STL

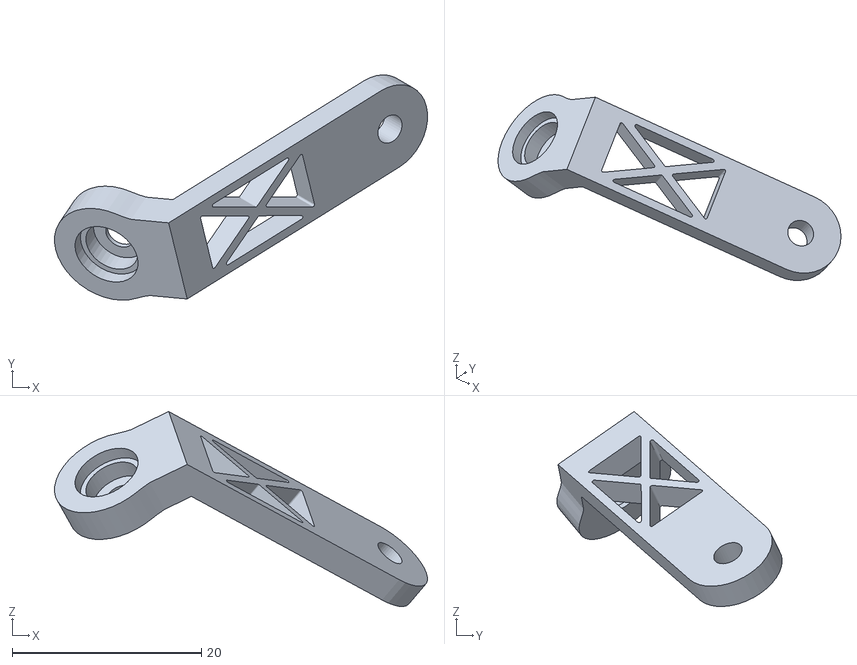
[picture p47: CAD file, 2026-02-28]
STL/TriCoSphere - 单指节-2 3-2支架-2.STL
39.4 x 23.8 x 20.6
