hurobomaster/TriCoSphere/STL/TriCoSphere - 单指节-1 短边连接-1.STL

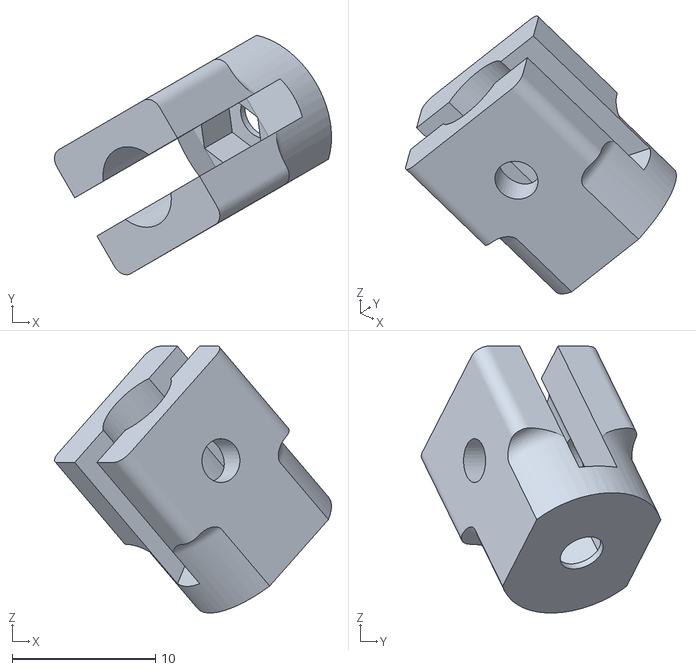
[picture p48: CAD file, 2026-02-28]
STL/TriCoSphere - 单指节-1 短边连接-1.STL
19.3 x 16.7 x 18.6
