hurobomaster/TriCoSphere/STL/TriCoSphere - 单指节-3 M2.5塞打-5.STL

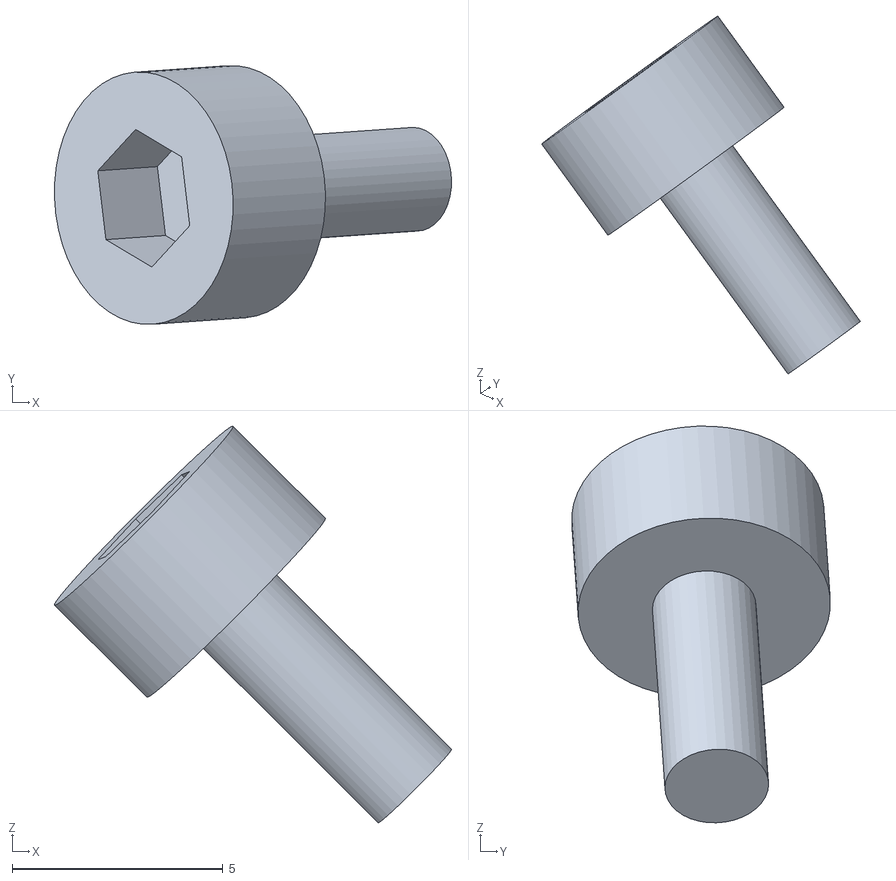
[picture p49: CAD file, 2026-02-28]
STL/TriCoSphere - 单指节-3 M2.5塞打-5.STL
9.42 x 6.14 x 9.42
