hurobomaster/TriCoSphere/STL/TriCoSphere - 单指节-3 球体-2.STL

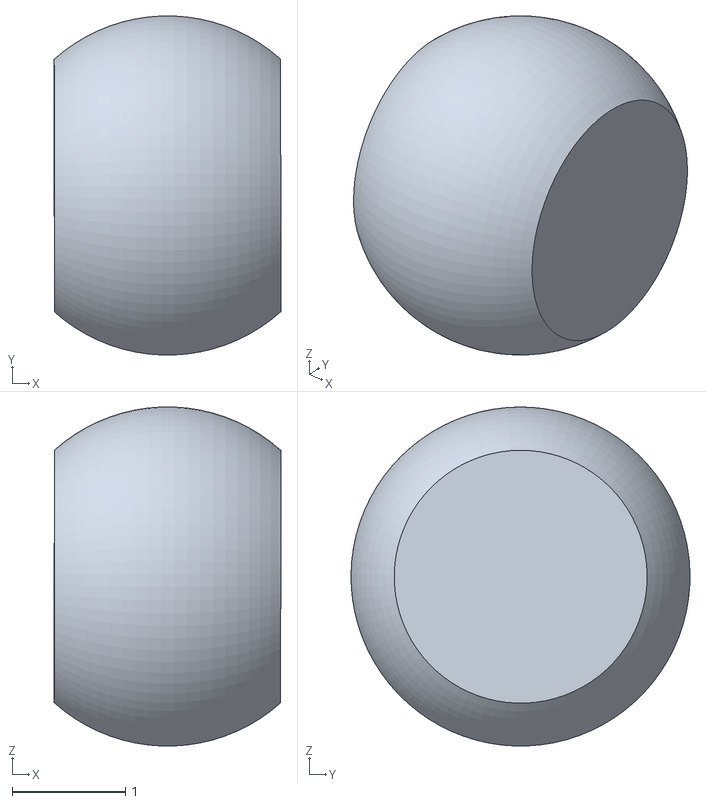
[picture p50: CAD file, 2026-02-28]
STL/TriCoSphere - 单指节-3 球体-2.STL
2.01 x 3.00 x 3.00
