hurobomaster/TriCoSphere/STL/TriCoSphere - 单指节-1 3-1支架-1.STL

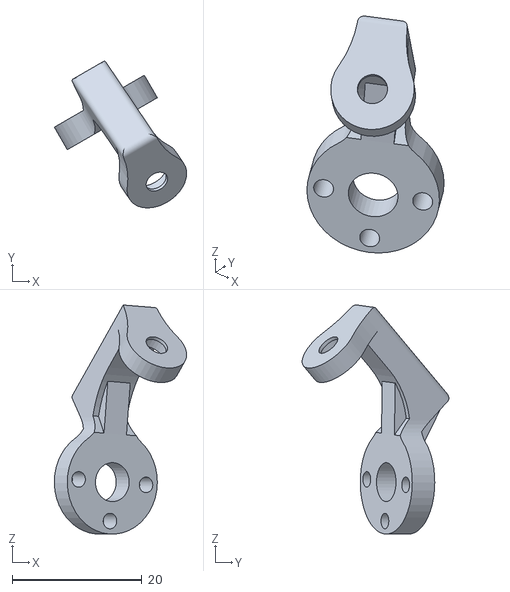
[picture p51: CAD file, 2026-02-28]
STL/TriCoSphere - 单指节-1 3-1支架-1.STL
20.4 x 22.6 x 35.2
