hurobomaster/TriCoSphere/STL/TriCoSphere - 单指节-3 M3螺母-6.STL

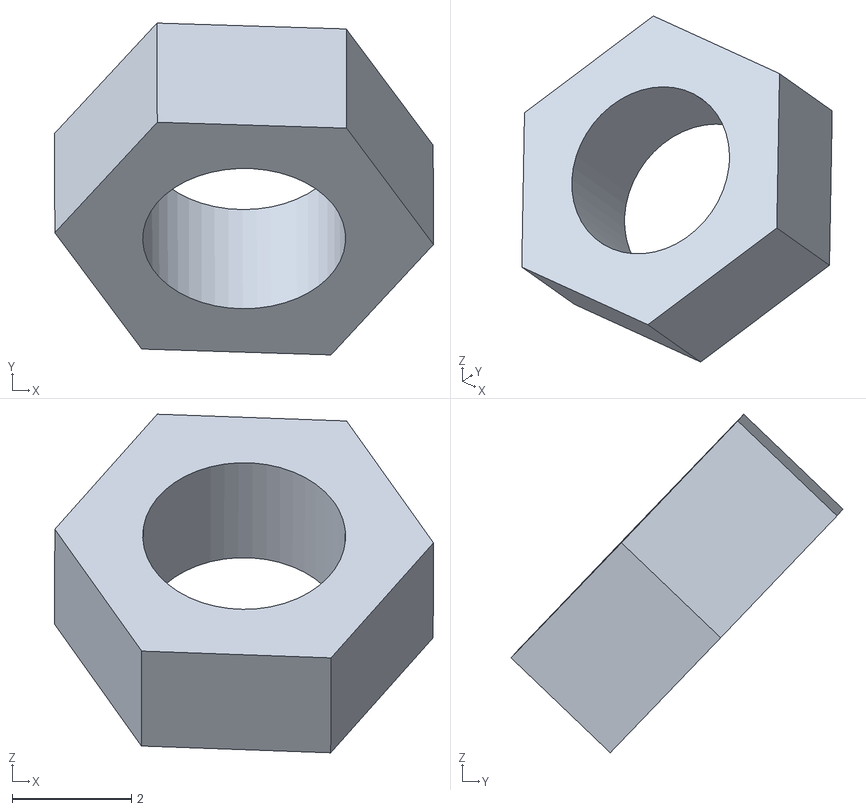
[picture p52: CAD file, 2026-02-28]
STL/TriCoSphere - 单指节-3 M3螺母-6.STL
6.35 x 5.56 x 5.67
