hurobomaster/TriCoSphere/STL/TriCoSphere - 单指节-3 3-2支架-2.STL

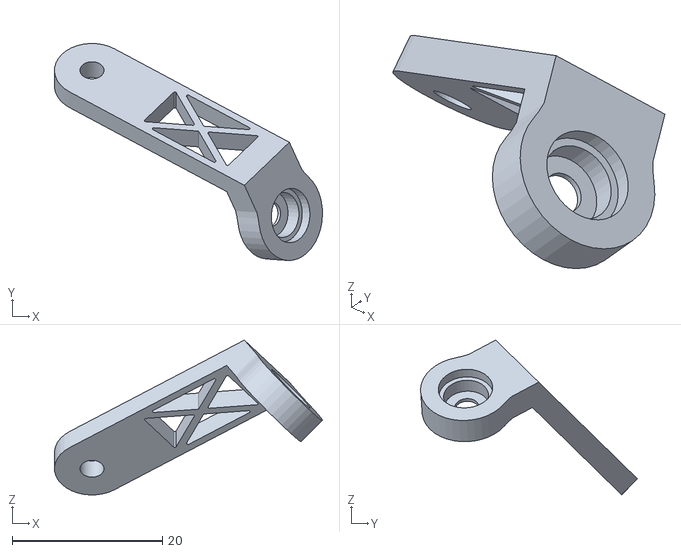
[picture p53: CAD file, 2026-02-28]
STL/TriCoSphere - 单指节-3 3-2支架-2.STL
35.7 x 28.9 x 20.6
