hurobomaster/TriCoSphere/STL/TriCoSphere - 单指节-2 末端杆件缩短版-2.STL

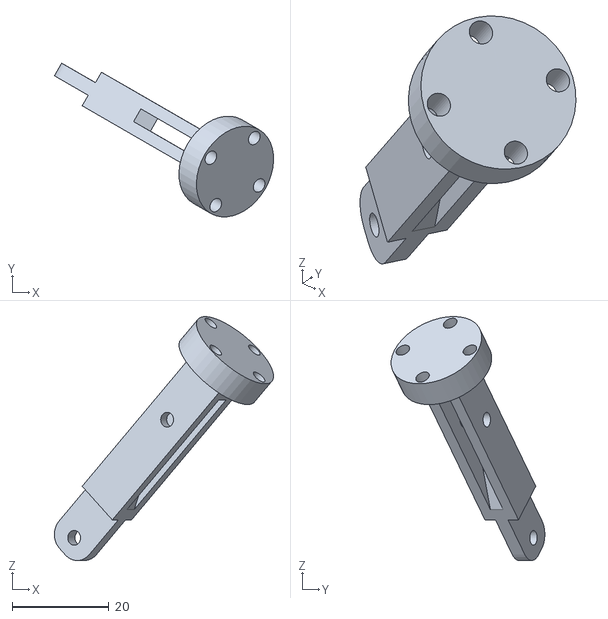
[picture p54: CAD file, 2026-02-28]
STL/TriCoSphere - 单指节-2 末端杆件缩短版-2.STL
45.3 x 31.8 x 50.5
