hurobomaster/TriCoSphere/STL/TriCoSphere - 单指节-1 长边件-9.STL

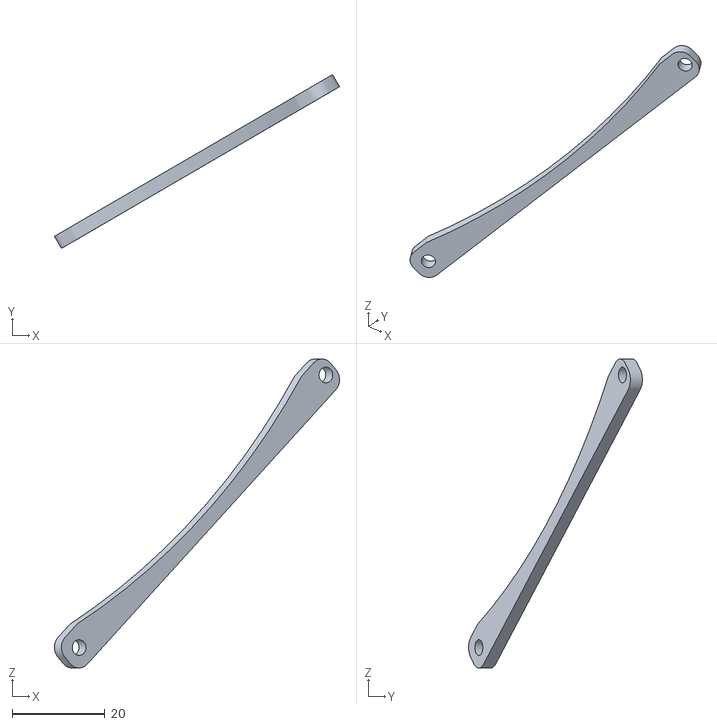
[picture p55: CAD file, 2026-02-28]
STL/TriCoSphere - 单指节-1 长边件-9.STL
61.4 x 37.4 x 66.5
