hurobomaster/TriCoSphere/STL/TriCoSphere - 单指节-1 长腿盖-1.STL

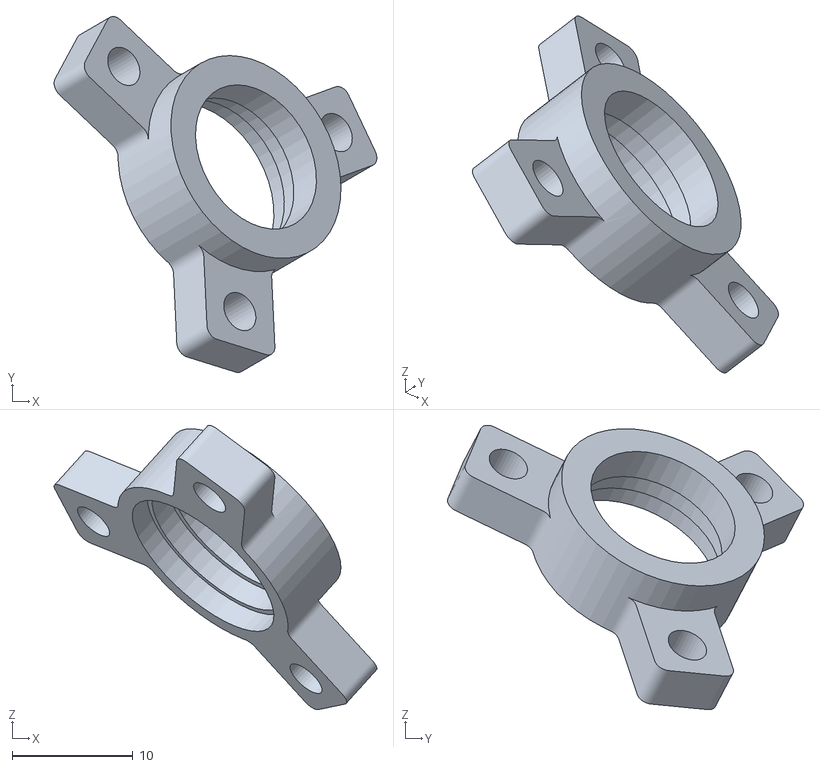
[picture p56: CAD file, 2026-02-28]
STL/TriCoSphere - 单指节-1 长腿盖-1.STL
26.7 x 29.4 x 23.5
