hurobomaster/TriCoSphere/STL/TriCoSphere - 单指节-2 M2.5塞打-5.STL

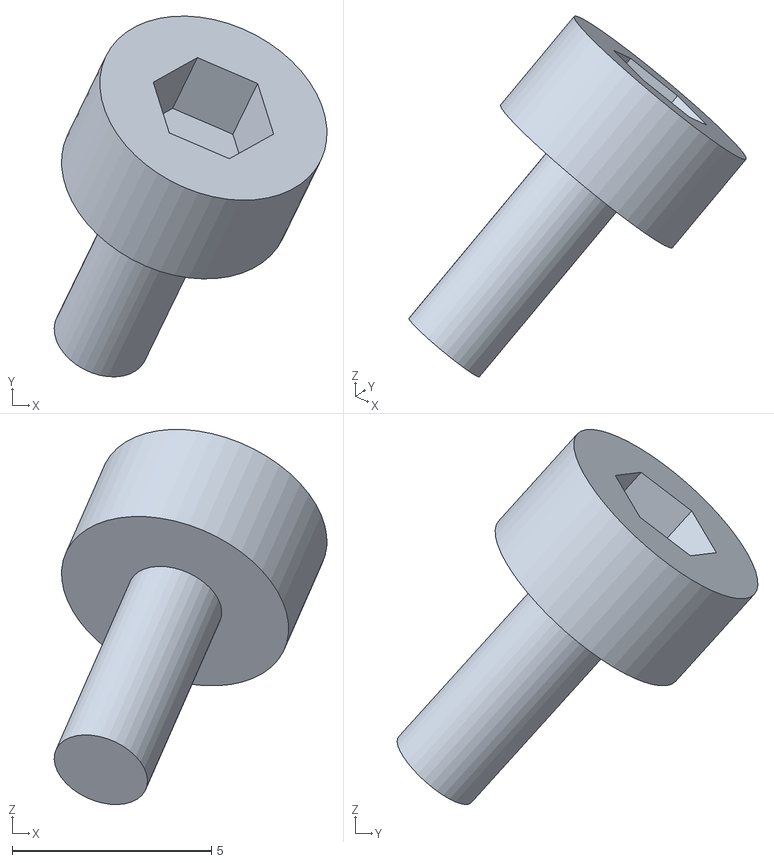
[picture p57: CAD file, 2026-02-28]
STL/TriCoSphere - 单指节-2 M2.5塞打-5.STL
6.85 x 9.06 x 9.42
