hurobomaster/TriCoSphere/STL/TriCoSphere - 单指节-2 推力球轴承3_8_3.5-4.STL

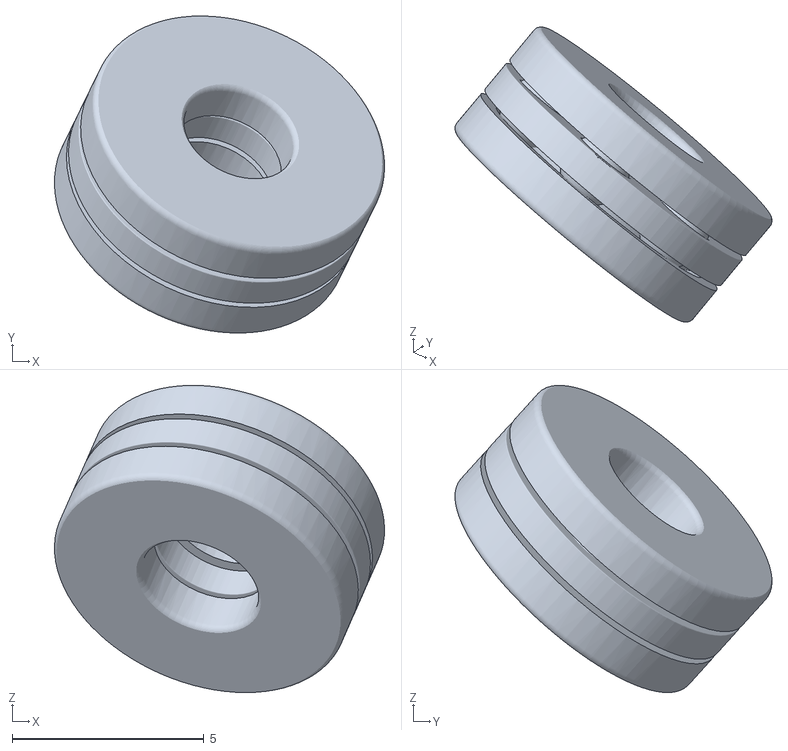
[picture p58: CAD file, 2026-02-28]
STL/TriCoSphere - 单指节-2 推力球轴承3_8_3.5-4.STL
8.60 x 8.26 x 8.00
