hurobomaster/TriCoSphere/STL/TriCoSphere - 单指节-1 1-2支架-1.STL

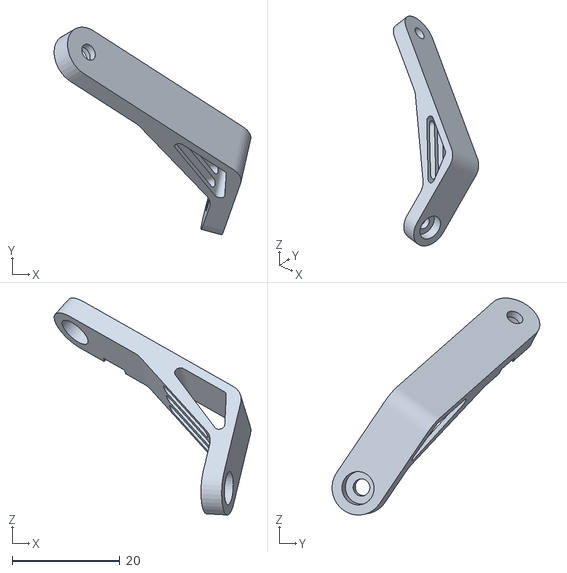
[picture p60: CAD file, 2026-02-28]
STL/TriCoSphere - 单指节-1 1-2支架-1.STL
36.5 x 38.6 x 40.3
