hurobomaster/TriCoSphere/STL/TriCoSphere - 单指节-3 长腿1-2.STL

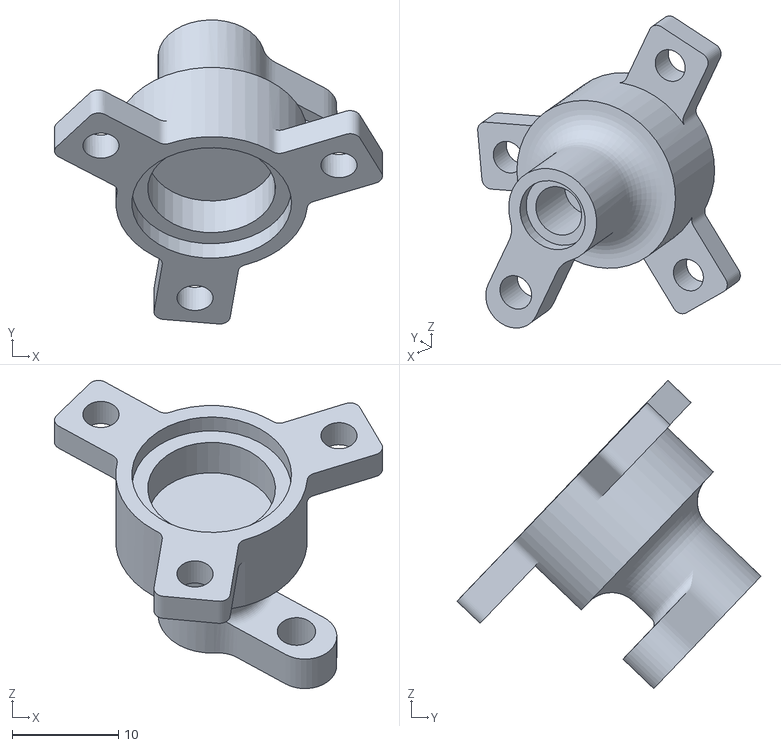
[picture p61: CAD file, 2026-02-28]
STL/TriCoSphere - 单指节-3 长腿1-2.STL
30.8 x 28.6 x 28.9
