hurobomaster/TriCoSphere/STL/TriCoSphere - 单指节-3 推力球轴承3_8_3.5-4.STL

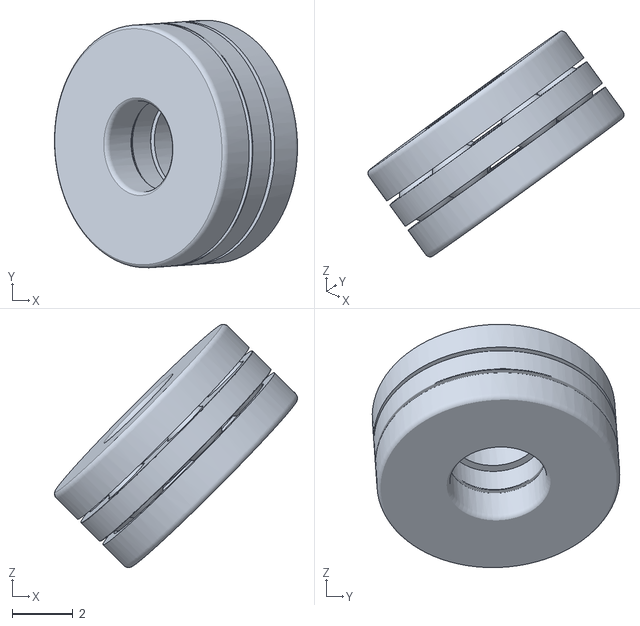
[picture p62: CAD file, 2026-02-28]
STL/TriCoSphere - 单指节-3 推力球轴承3_8_3.5-4.STL
8.00 x 8.14 x 8.00
