hurobomaster/TriCoSphere/STL/TriCoSphere - 基准台座-1.STL

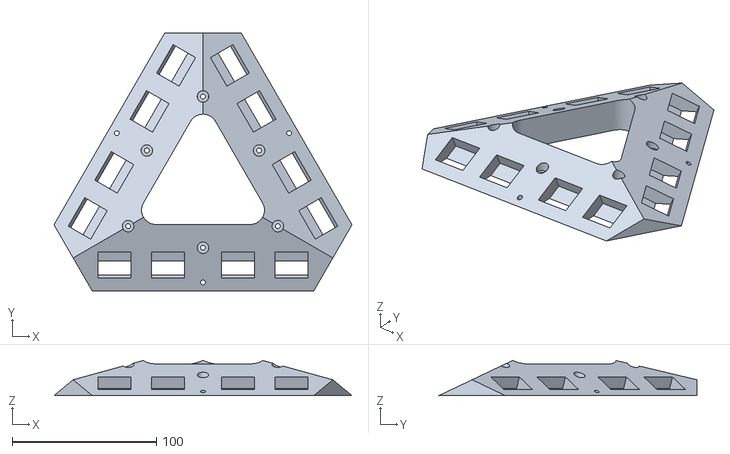
[picture p63: CAD file, 2026-02-28]
STL/TriCoSphere - 基准台座-1.STL
206.9 x 179.2 x 24.4
