hurobomaster/TriCoSphere/STL/TriCoSphere - 单指节-2 长腿盖-1.STL

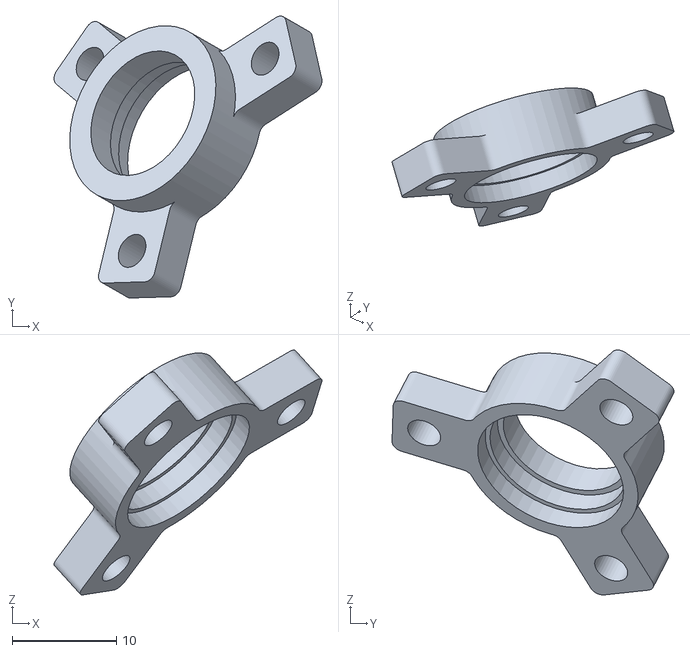
[picture p64: CAD file, 2026-02-28]
STL/TriCoSphere - 单指节-2 长腿盖-1.STL
25.7 x 27.1 x 23.5
