hurobomaster/TriCoSphere/STL/TriCoSphere - 单指节-3 2-1支架-1.STL

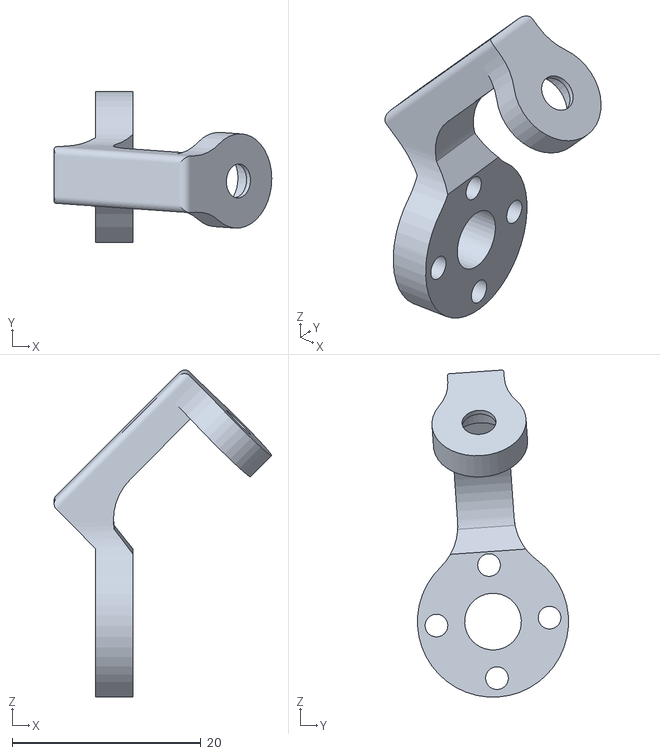
[picture p65: CAD file, 2026-02-28]
STL/TriCoSphere - 单指节-3 2-1支架-1.STL
23.0 x 16.0 x 34.6
