hurobomaster/TriCoSphere/STL/TriCoSphere - 单指节-2 长边件-9.STL

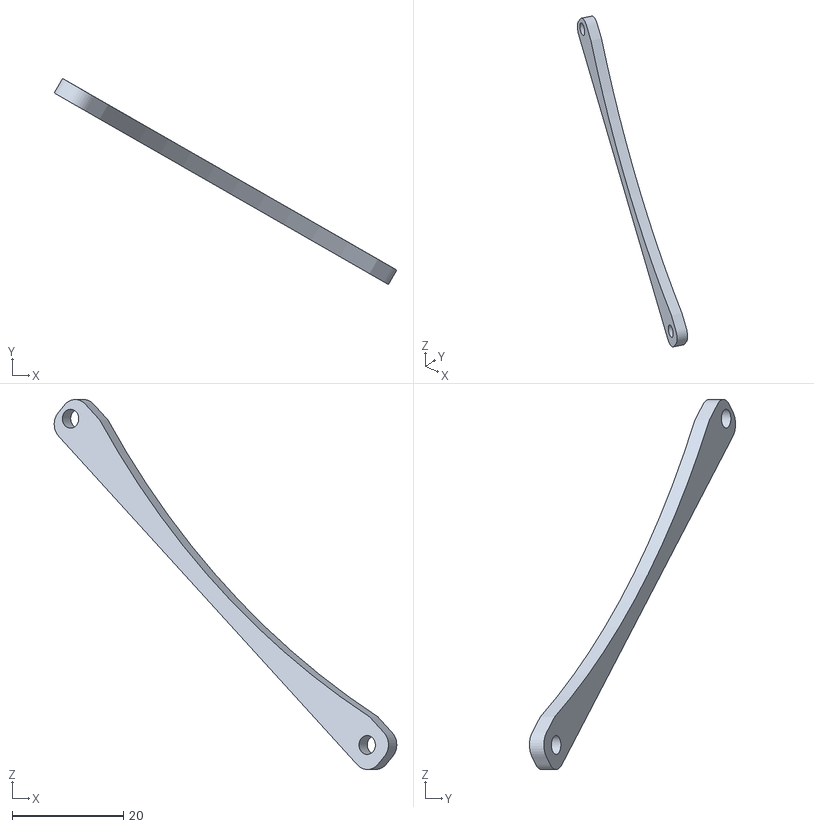
[picture p66: CAD file, 2026-02-28]
STL/TriCoSphere - 单指节-2 长边件-9.STL
61.6 x 37.1 x 66.5
