hurobomaster/TriCoSphere/STL/TriCoSphere - 单指节-1 4-2支架-2.STL

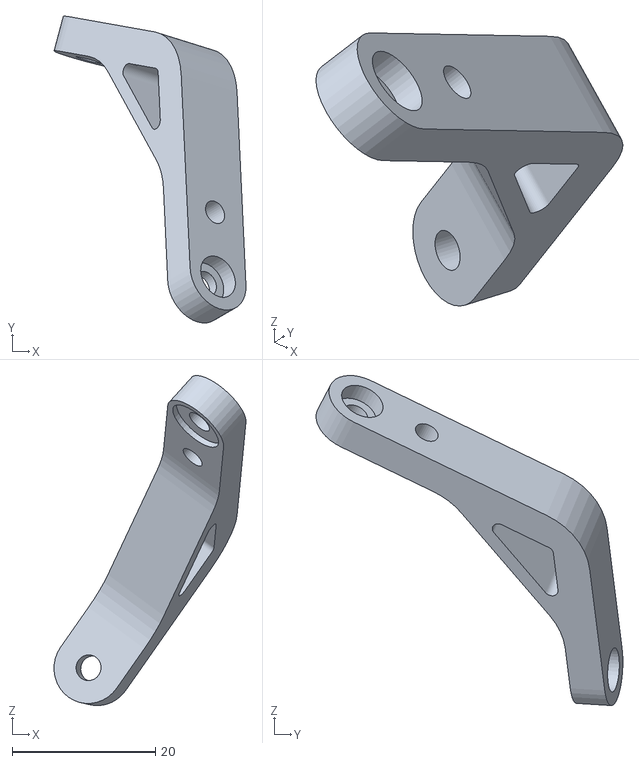
[picture p67: CAD file, 2026-02-28]
STL/TriCoSphere - 单指节-1 4-2支架-2.STL
26.8 x 42.8 x 46.1
