hurobomaster/TriCoSphere/STL/TriCoSphere - 单指节-2 3-1支架-1.STL

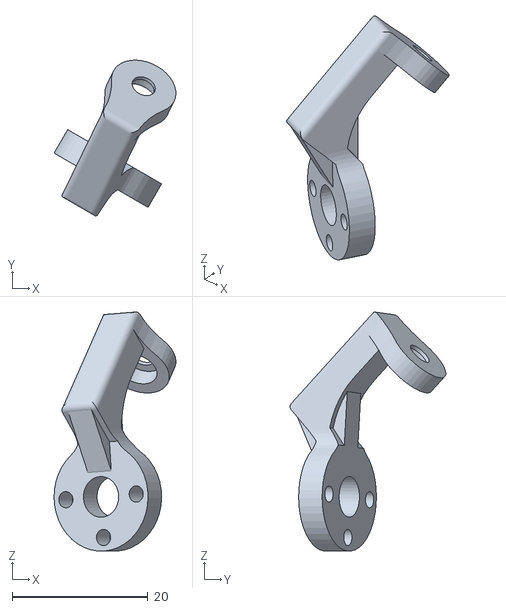
[picture p68: CAD file, 2026-02-28]
STL/TriCoSphere - 单指节-2 3-1支架-1.STL
18.0 x 23.0 x 35.2
