hurobomaster/TriCoSphere/STL/TriCoSphere - 单指节-3 M2.5锁紧螺母-1.STL

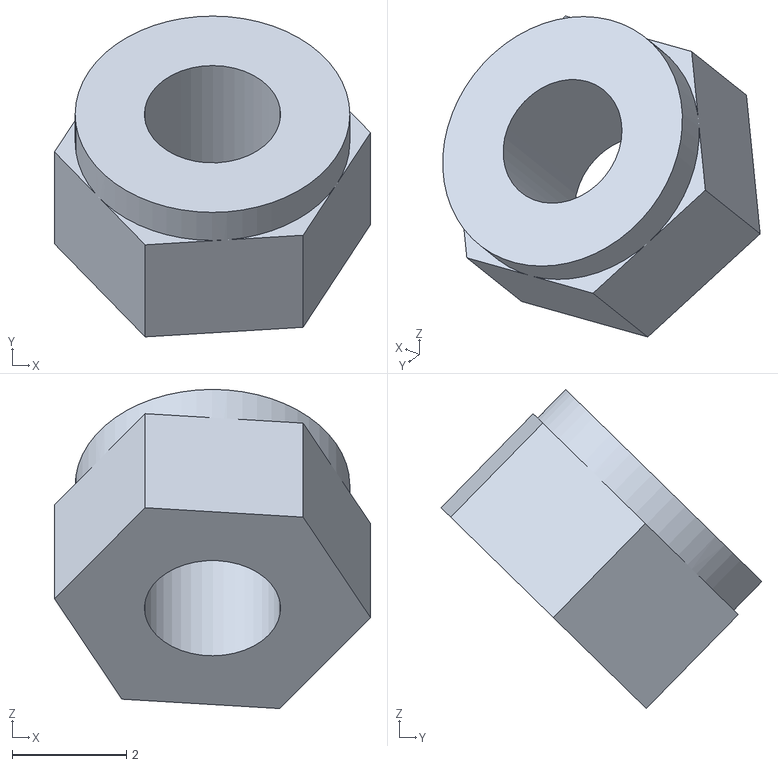
[picture p69: CAD file, 2026-02-28]
STL/TriCoSphere - 单指节-3 M2.5锁紧螺母-1.STL
5.52 x 5.61 x 5.58
