hurobomaster/TriCoSphere/STL/TriCoSphere - 单指节-3 M3螺母-4.STL

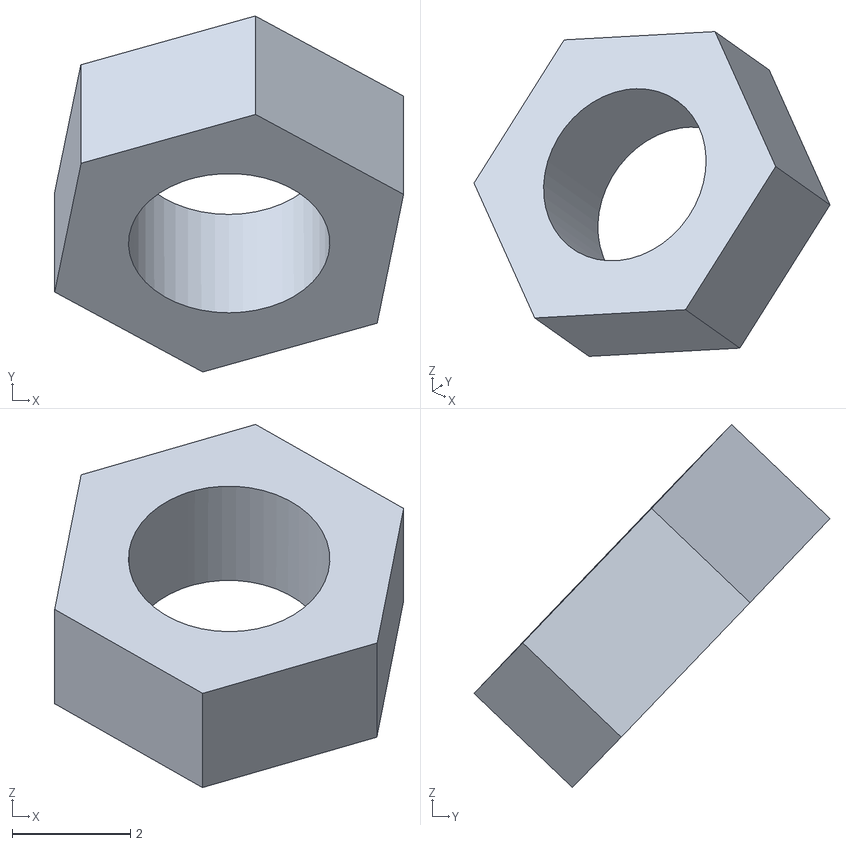
[picture p70: CAD file, 2026-02-28]
STL/TriCoSphere - 单指节-3 M3螺母-4.STL
5.90 x 6.01 x 6.13
