hurobomaster/TriCoSphere/STL/TriCoSphere - 单指节-1 M2.5锁紧螺母-1.STL

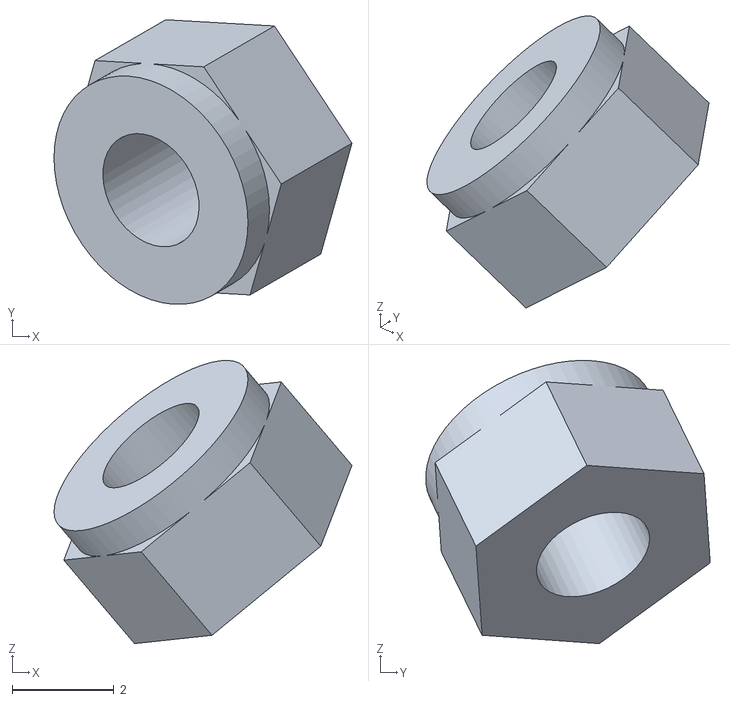
[picture p71: CAD file, 2026-02-28]
STL/TriCoSphere - 单指节-1 M2.5锁紧螺母-1.STL
5.87 x 5.60 x 5.58
