hurobomaster/TriCoSphere/STL/TriCoSphere - 单指节-3 中指模块-1.STL

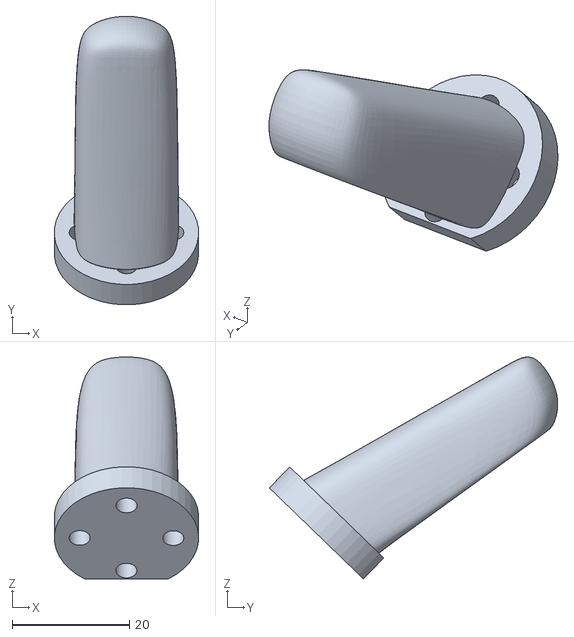
[picture p72: CAD file, 2026-02-28]
STL/TriCoSphere - 单指节-3 中指模块-1.STL
24.6 x 49.3 x 37.9
