hurobomaster/TriCoSphere/STL/TriCoSphere - 单指节-3 4-2支架-2.STL

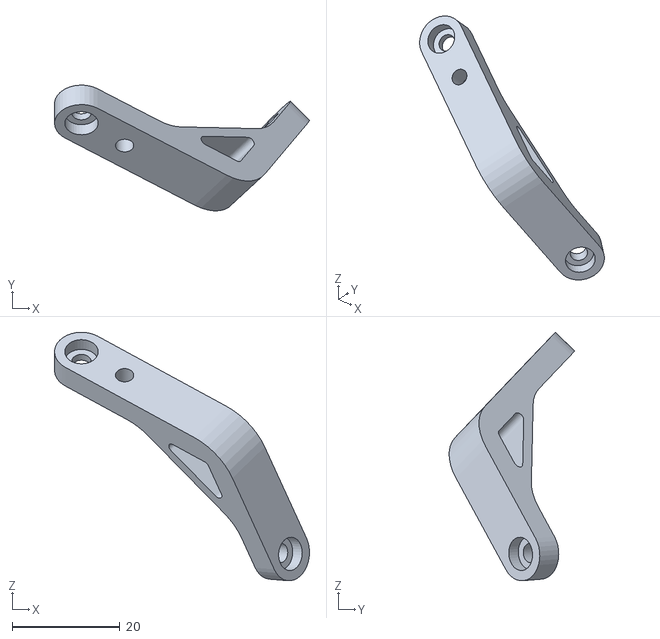
[picture p73: CAD file, 2026-02-28]
STL/TriCoSphere - 单指节-3 4-2支架-2.STL
47.3 x 23.3 x 46.1
