hurobomaster/TriCoSphere/STL/TriCoSphere - 单指节-2 长腿1-2.STL

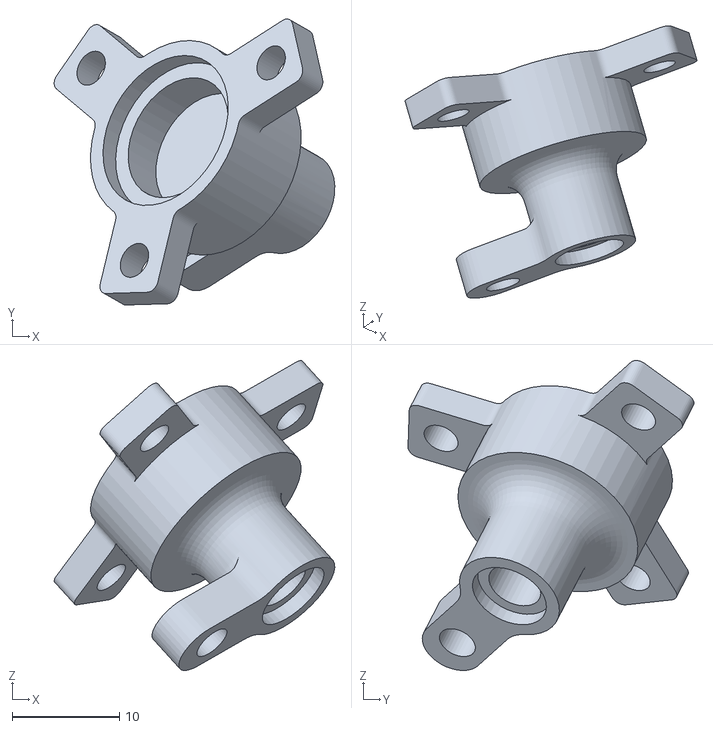
[picture p74: CAD file, 2026-02-28]
STL/TriCoSphere - 单指节-2 长腿1-2.STL
26.2 x 26.7 x 28.9
