hurobomaster/TriCoSphere/STL/TriCoSphere - 单指节-3 末端杆件缩短版-2.STL

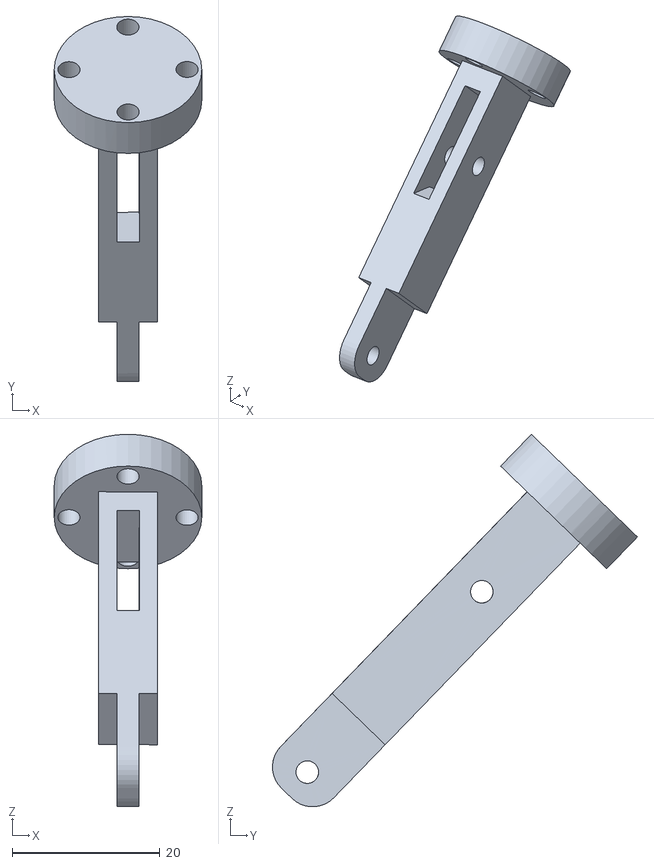
[picture p75: CAD file, 2026-02-28]
STL/TriCoSphere - 单指节-3 末端杆件缩短版-2.STL
20.0 x 49.4 x 50.5
