hurobomaster/TriCoSphere/STL/TriCoSphere - 单指节-2 4-2支架-2.STL

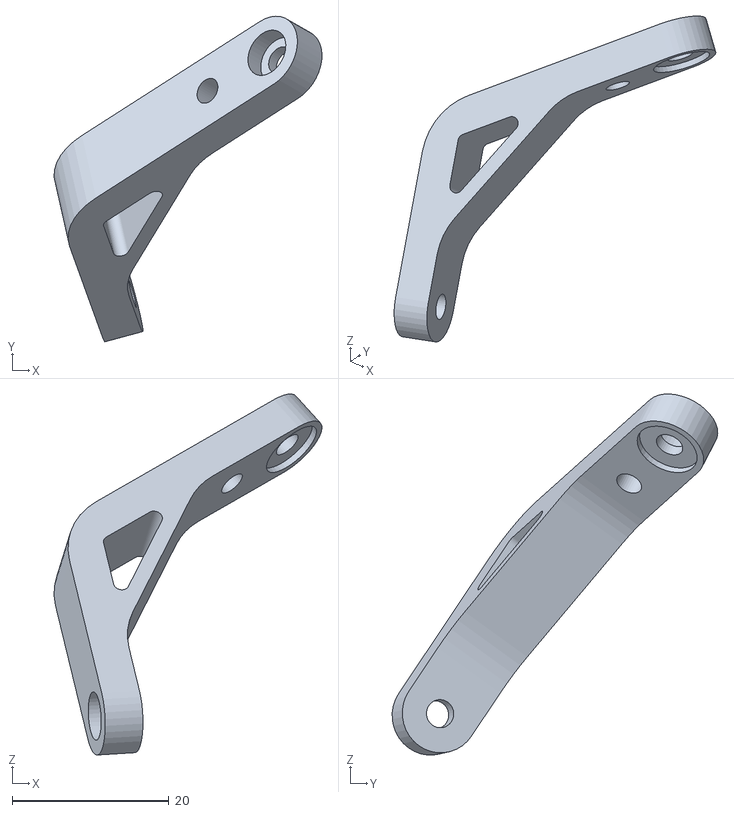
[picture p76: CAD file, 2026-02-28]
STL/TriCoSphere - 单指节-2 4-2支架-2.STL
34.2 x 41.5 x 46.1
