hurobomaster/TriCoSphere/STL/TriCoSphere - 单指节-1 2-2支架-4.STL

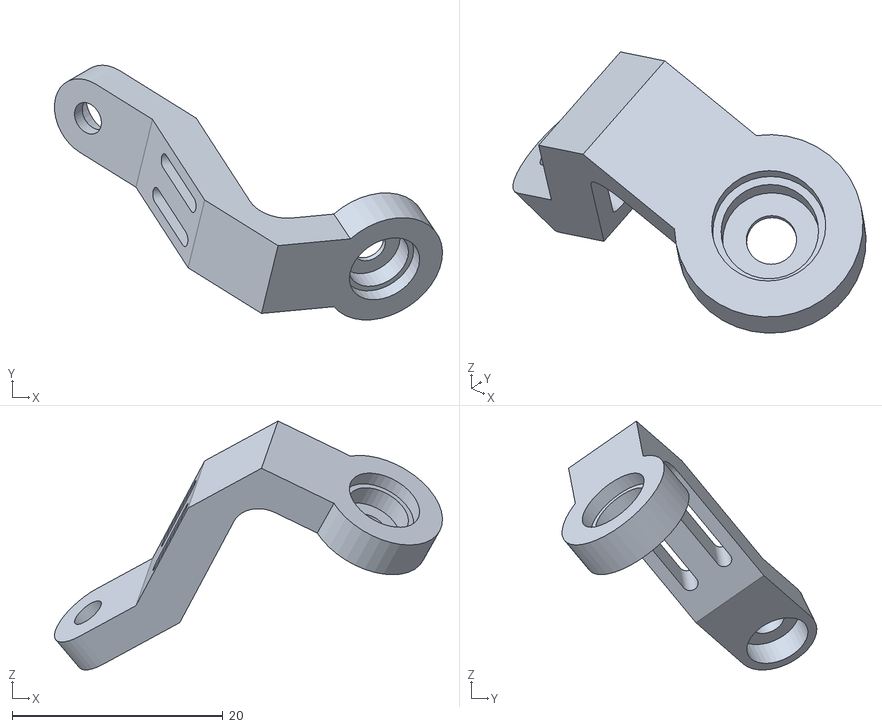
[picture p77: CAD file, 2026-02-28]
STL/TriCoSphere - 单指节-1 2-2支架-4.STL
36.8 x 24.2 x 23.6
