hurobomaster/TriCoSphere/STL/TriCoSphere - 单指节-1 3-2支架-2.STL

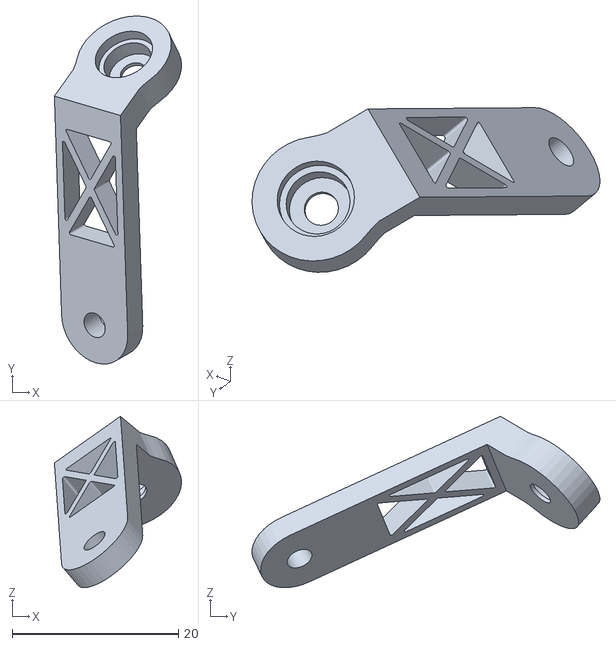
[picture p78: CAD file, 2026-02-28]
STL/TriCoSphere - 单指节-1 3-2支架-2.STL
15.3 x 41.9 x 20.6
