hurobomaster/TriCoSphere/(list of files, cad)

Other CAD files:
STL/TriCoSphere - 单指节-3 挡边轴承3-6-2.5-5.STL
STL/TriCoSphere - 单指节-1 推力球轴承3_8_3.5-4.STL
STL/TriCoSphere - 单指节-1 挡边轴承3-6-2.5-5.STL
STL/TriCoSphere - 单指节-2 aututorM288-3.STL
STL/TriCoSphere - 单指节-3 挡边轴承3-6-2.5-24.STL
STL/TriCoSphere - 单指节-3 挡边轴承3-6-2.5-22.STL
STL/TriCoSphere - 单指节-2 内六角杯头螺栓 SCA SCAS[SCA-M3-L8]-1.STL
STL/TriCoSphere - 单指节-2 内六角杯头螺栓 SCA SCAS[SCA-M3-L8]-4.STL
STL/TriCoSphere - 单指节-3 aututorM288-4.STL
STL/TriCoSphere - 单指节-3 挡边轴承3-6-2.5-26.STL
STL/TriCoSphere - 单指节-3 推力球轴承3_8_3.5-6.STL
STL/TriCoSphere - 单指节-3 aututorM288-1.STL
STL/TriCoSphere - 单指节-1 内六角杯头螺栓 SCA SCAS[SCA-M3-L8]-4.STL
STL/TriCoSphere - 单指节-1 挡边轴承3-6-2.5-16.STL
STL/TriCoSphere - 单指节-1 aututorM288-2.STL
STL/TriCoSphere - 单指节-2 4-1支架-2.STL
STL/TriCoSphere - 单指节-3 内六角杯头螺栓 SCA SCAS[SCA-M3-L8]-3.STL
STL/TriCoSphere - 单指节-2 挡边轴承3-6-2.5-22.STL
STL/TriCoSphere - 单指节-1 aututorM288-3.STL
STL/TriCoSphere - 单指节-2 挡边轴承3-6-2.5-23.STL
STL/TriCoSphere - 单指节-1 M3螺母-6.STL
STL/TriCoSphere - 单指节-2 M2.5塞打-2.STL
STL/TriCoSphere - 单指节-2 挡边轴承3-6-2.5-9.STL
STL/TriCoSphere - 单指节-1 超薄轴承-3.STL
STL/TriCoSphere - 单指节-1 内六角杯头螺栓 SCA SCAS[SCA-M3-L8]-2.STL
STL/TriCoSphere - 单指节-3 内六角杯头螺栓 SCA SCAS[SCA-M3-L8]-2.STL
STL/TriCoSphere - 单指节-1 末端杆件缩短版-2.STL
STL/TriCoSphere - 单指节-2 推力球轴承3_8_3.5-6.STL
STL/TriCoSphere - 单指节-2 aututorM288-4.STL
STL/TriCoSphere - 单指节-3 M2.5塞打-2.STL
STL/TriCoSphere - 单指节-2 挡边轴承3-6-2.5-17.STL
STL/TriCoSphere - 单指节-2 内六角杯头螺栓 SCA SCAS[SCA-M3-L8]-5.STL
STL/TriCoSphere - 单指节-1 挡边轴承3-6-2.5-17.STL
STL/TriCoSphere - 单指节-2 M3螺母-1.STL
STL/TriCoSphere - 单指节-3 M2.5塞打-3.STL
STL/TriCoSphere - 单指节-1 挡边轴承3-6-2.5-22.STL
STL/TriCoSphere - 单指节-1 M2.5塞打-3.STL
STL/TriCoSphere - 单指节-1 M3螺母-5.STL
STL/TriCoSphere - 单指节-1 M3螺母-2.STL
STL/TriCoSphere - 单指节-1 挡边轴承3-6-2.5-25.STL
STL/TriCoSphere - 单指节-1 aututorM288-4.STL
STL/TriCoSphere - 单指节-3 挡边轴承3-6-2.5-17.STL
STL/TriCoSphere - 单指节-1 内六角杯头螺栓 SCA SCAS[SCA-M3-L8]-1.STL
STL/TriCoSphere - 单指节-2 aututorM288-1.STL
STL/TriCoSphere - 单指节-3 挡边轴承3-6-2.5-23.STL
STL/TriCoSphere - 单指节-3 内六角杯头螺栓 SCA SCAS[SCA-M3-L8]-1.STL
STL/TriCoSphere - 单指节-2 内六角杯头螺栓 SCA SCAS[SCA-M3-L8]-3.STL
STL/TriCoSphere - 单指节-1 长腿2-1.STL
STL/TriCoSphere - 单指节-3 挡边轴承3-6-2.5-21.STL
STL/TriCoSphere - 单指节-1 M2.5塞打-1.STL
STL/TriCoSphere - 单指节-2 M3螺母-6.STL
STL/TriCoSphere - 单指节-1 内六角杯头螺栓 SCA SCAS[SCA-M3-L8]-3.STL
STL/TriCoSphere - 单指节-2 M2.5塞打-4.STL
STL/TriCoSphere - 单指节-3 M2.5塞打-1.STL
STL/TriCoSphere - 单指节-1 挡边轴承3-6-2.5-21.STL
STL/TriCoSphere - 单指节-3 4-1支架-1.STL
STL/TriCoSphere - 单指节-1 内六角杯头螺栓 SCA SCAS[SCA-M3-L8]-5.STL
STL/TriCoSphere - 单指节-1 M2.5塞打-4.STL
STL/TriCoSphere - 单指节-2 短边连接-1.STL
STL/TriCoSphere - 单指节-1 推力球轴承3_8_3.5-5.STL
STL/TriCoSphere - 单指节-3 M3螺母-2.STL
STL/TriCoSphere - 单指节-3 M3螺母-1.STL
STL/TriCoSphere - 单指节-3 aututorM288-3.STL
STL/TriCoSphere - 单指节-2 4-1支架-1.STL
STL/TriCoSphere - 单指节-2 挡边轴承3-6-2.5-5.STL
STL/TriCoSphere - 单指节-1 挡边轴承3-6-2.5-9.STL
STL/TriCoSphere - 单指节-3 内六角杯头螺栓 SCA SCAS[SCA-M3-L8]-5.STL
STL/TriCoSphere - 单指节-1 挡边轴承3-6-2.5-23.STL
STL/TriCoSphere - 单指节-3 推力球轴承3_8_3.5-5.STL
STL/TriCoSphere - 单指节-2 M2.5塞打-1.STL
STL/TriCoSphere - 单指节-3 挡边轴承3-6-2.5-16.STL
STL/TriCoSphere - 单指节-2 中指模块-1.STL
STL/TriCoSphere - 单指节-1 挡边轴承3-6-2.5-24.STL
STL/TriCoSphere - 单指节-1 推力球轴承3_8_3.5-9.STL
STL/TriCoSphere - 单指节-2 M2.5塞打-3.STL
STL/TriCoSphere - 单指节-2 aututorM288-2.STL
STL/TriCoSphere - 单指节-2 挡边轴承3-6-2.5-24.STL
STL/TriCoSphere - 单指节-2 推力球轴承3_8_3.5-7.STL
STL/TriCoSphere - 单指节-3 M3螺母-5.STL
STL/TriCoSphere - 单指节-3 超薄轴承-3.STL
